SebastianHampl18/Projektarbeit-Bierautomat/Altiumprojekt/Project Outputs for Bierautomat/ESP-Träger Platine/ESP_Träger.png

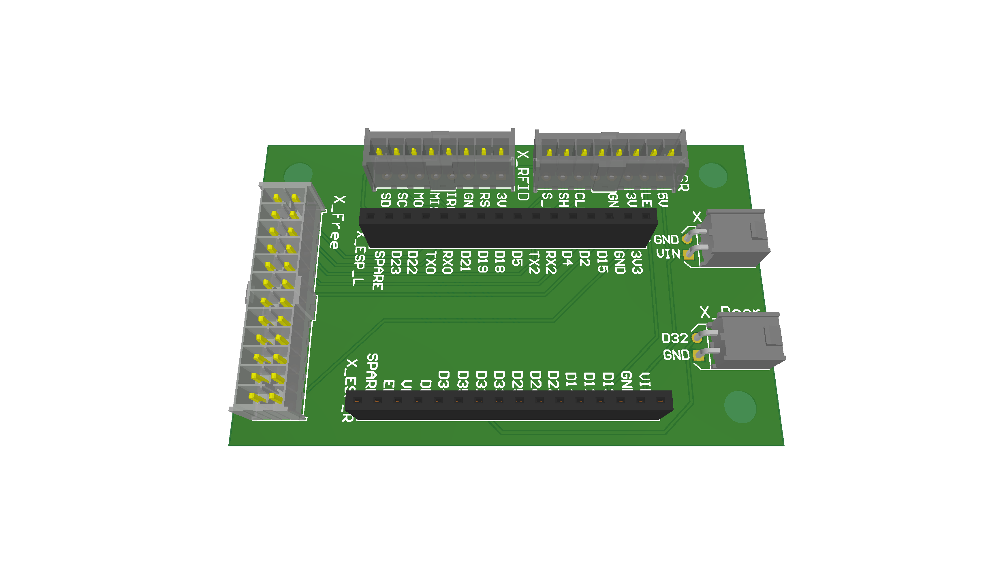
Altiumprojekt/Project Outputs for Bierautomat/ESP-Träger Platine/ESP_Träger.png
