SebastianHampl18/Projektarbeit-Bierautomat/Altiumprojekt/Project Outputs for Bierautomat/ESP-Träger Platine/ESP_Träger_top.png

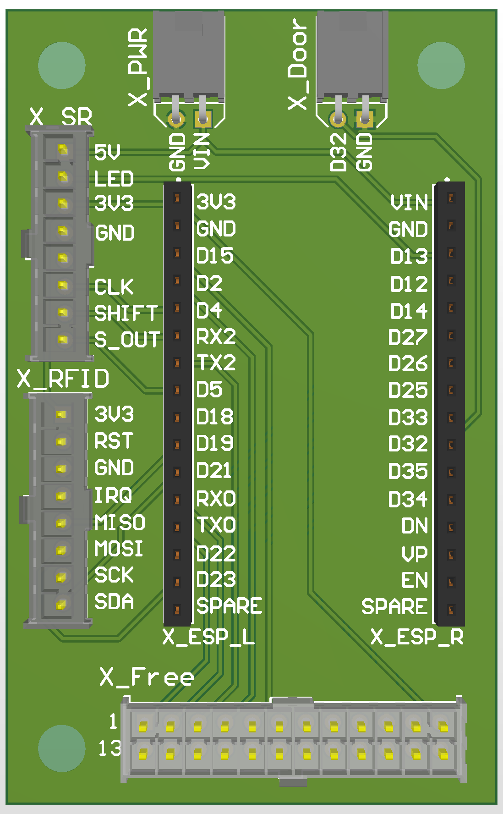
Altiumprojekt/Project Outputs for Bierautomat/ESP-Träger Platine/ESP_Träger_top.png
