SebastianHampl18/Projektarbeit-Bierautomat/Altiumprojekt/Project Outputs for Bierautomat/Schieberegister-Platine/SR_Träger_top.png

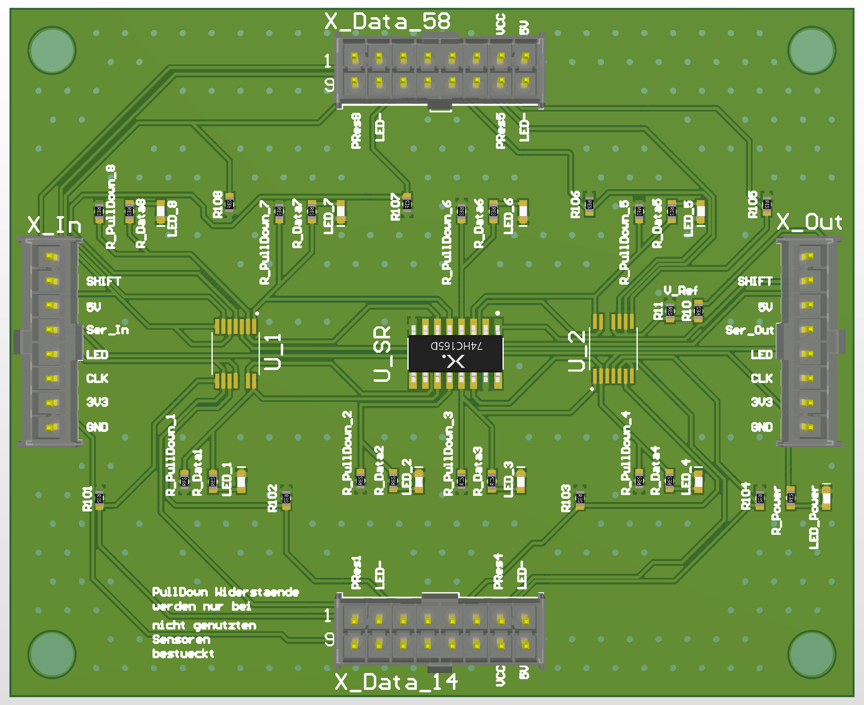
Altiumprojekt/Project Outputs for Bierautomat/Schieberegister-Platine/SR_Träger_top.png
