SebastianHampl18/Projektarbeit-Bierautomat/Altiumprojekt/Project Outputs for Bierautomat/ESP-Träger Platine/BOM_ESP_Träger.xlsx

Part Number | Manufacturer | Quantity | Value | Package | Description | Designator | Footprint | Comment
IPL1-108-01-L-S-K | Samtec | 1 |  |  | Samtec IPL1 .100", 8-polig, eine Reihe | X_RFID | Samtec-IPL1-108-01-L-S-K | Samtec-IPL1-108-01-L-S-K
IPL1-102-01-L-S-RA-K | Samtec | 2 |  |  | Samtec IPL1 .100", 2polig, eine Reihe, 90° gewinkelt | X_Door, X_PWR | Samtec-IPL1-102-01-L-S-RA-K | Samtec-IPL1-102-01-L-S-RA-K
 |  | 2 |  |  |  | X_ESP_L?, X_ESP_R? | 61301611821 | 61301611821
 |  | 1 | Samtec-IPL1-108-01-L-S-K |  | Header, 8-Pin | X_SR | Samtec-IPL1-108-01-L-S-K | Samtec-IPL1-108-01-L-S-K
 |  | 1 | Samtec-IPL1-112-01-L-D-K |  | Header, 12-Pin, Dual row | X_Free | Samtec-IPL1-112-01-L-D-K | Samtec-IPL1-112-01-L-D-K
