SebastianHampl18/Projektarbeit-Bierautomat/Altiumprojekt/Project Outputs for Bierautomat/Schieberegister-Platine/BOM_SR_Platine.xlsx

Part Number | Manufacturer | Quantity | Value | Package | Description | Designator | Footprint | Comment
R___=Value |  | 17 |  |  | Resistor, 0603, 5% default, 0.1 W | R101, R102, R103, R104, R105, R106, R107, R108, R_PullDown_1, R_PullDown_2, R_PullDown_3, R_PullDown_4, R_PullDown_5, R_PullDown_6, R_PullDown_7, R_PullDown_8, R_PullDown_SER | 0603_resistor_flat | R___=Value, 2k7
R___220 |  | 8 | 220 |  | Resistor, 0603, 5% default, 0.1 W | R1, R2, R3, R4, R5, R6, R7, R8 | 0603_resistor_flat | R___220
R_0603_1%_xx |  | 2 | xx |  | Resistor, 0603, 5% default, 0.1 W | R10, R11 | 0603_resistor_flat | R_0603_1%_xx
R_0603_1%_3k3 |  | 9 | 3k3 |  | Resistor, 0603, 5% default, 0.1 W | R_Data1, R_Data2, R_Data3, R_Data4, R_Data5, R_Data6, R_Data7, R_Data8, R_Power | 0603_resistor_flat | R_0603_1%_3k3
150060*75000 | Würth | 9 |  |  | 0603 SMD mono-color Chip LED, WL-SMCW BS: Blue, GS: Green, RS: Red, SS: super red, VS: bright green, YS: yellow | LED_1, LED_2, LED_3, LED_4, LED_5, LED_6, LED_7, LED_8, LED_Power | 150060XX75000 | 150060*75000
 |  | 1 |  |  | MOSFET N-CH 30V 3.8A SOT23 | Q_LED | SOT95P280X125-3N | AO3418
 |  | 2 |  | TSSOP-14 Rohm | Quad differential comparator, automotive grade 14-TSSOP -40 to 125 | U_1, U_2 | SOP65P640X120-14N | LM2901PWR
 |  | 2 | Samtec |  | Header, 8-Pin, Dual row | X_Data_14, X_Data_58 | Samtec-IPL1-108-01-L-D-K | Samtec-IPL1-108-01-L-D-K
 |  | 2 | Samtec-IPL1-108-01-L-S-K |  | Header, 8-Pin | X_In, X_Out | Samtec-IPL1-108-01-L-S-K | Samtec-IPL1-108-01-L-S-K
 | Nexperia | 1 |  | SOT109-1 | IC SHIFT REGST 8BIT PI-SO 16SOIC | U_SR | FP-SOT109-1-MFG | 74HC165D,653
