SebastianHampl18/Projektarbeit-Bierautomat/Altiumprojekt/Project Outputs for Bierautomat/Schieberegister-Platine/Electrical Rules Check_SR_Platine.PDF

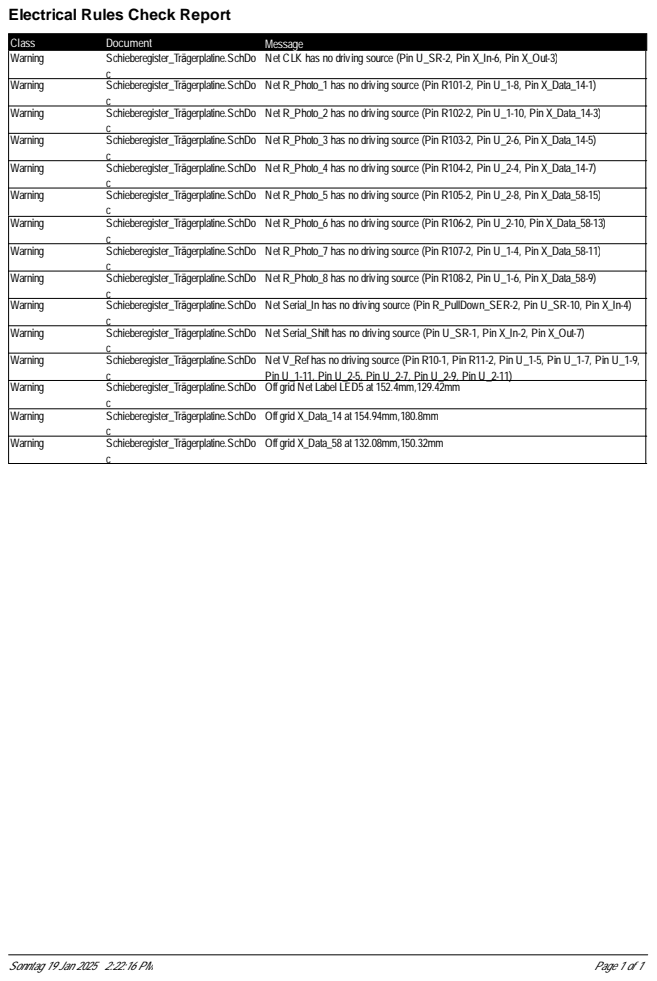
[picture p25: page 1]

Electrical Rules Check Report

Net CLK has no driving source (Pin U_SR-2, Pin X_In-6, Pin X_Out-3)

Net R_Photo_1 has no driving source (Pin R101-2, Pin U_1-8, Pin X_Data_14-1)

Net R_Photo_2 has no driving source (Pin R102-2, Pin U_1-10, Pin X_Data_14-3)

Net R_Photo_3 has no driving source (Pin R103-2, Pin U_2-6, Pin X_Data_14-5)

Net R_Photo_4 has no driving source (Pin R104-2, Pin U_2-4, Pin X_Data_14-7)

Net R_Photo_5 has no driving source (Pin R105-2, Pin U_2-8, Pin X_Data_58-15)

Net R_Photo_6 has no driving source (Pin R106-2, Pin U_2-10, Pin X_Data_58-13)

Net R_Photo_7 has no driving source (Pin R107-2, Pin U_1-4, Pin X_Data_58-11)

Net R_Photo_8 has no driving source (Pin R108-2, Pin U_1-6, Pin X_Data_58-9)

Net Serial_In has no driving source (Pin R_PullDown_SER-2, Pin U_SR-10, Pin X_In-4)

Net Serial_Shift has no driving source (Pin U_SR-1, Pin X_In-2, Pin X_Out-7)

Net V_Ref has no driving source (Pin R10-1, Pin R11-2, Pin U_1-5, Pin U_1-7, Pin U_1-9,
Pin U_1-11, Pin U_2-5, Pin U_2-7, Pin U_2-9, Pin U_2-11)
Off grid Net Label LED5 at 152.4mm,129.42mm
