SebastianHampl18/Projektarbeit-Bierautomat/Altiumprojekt/Project Outputs for Bierautomat/ESP-Träger Platine/Assembly_ESP_Träger.PDF

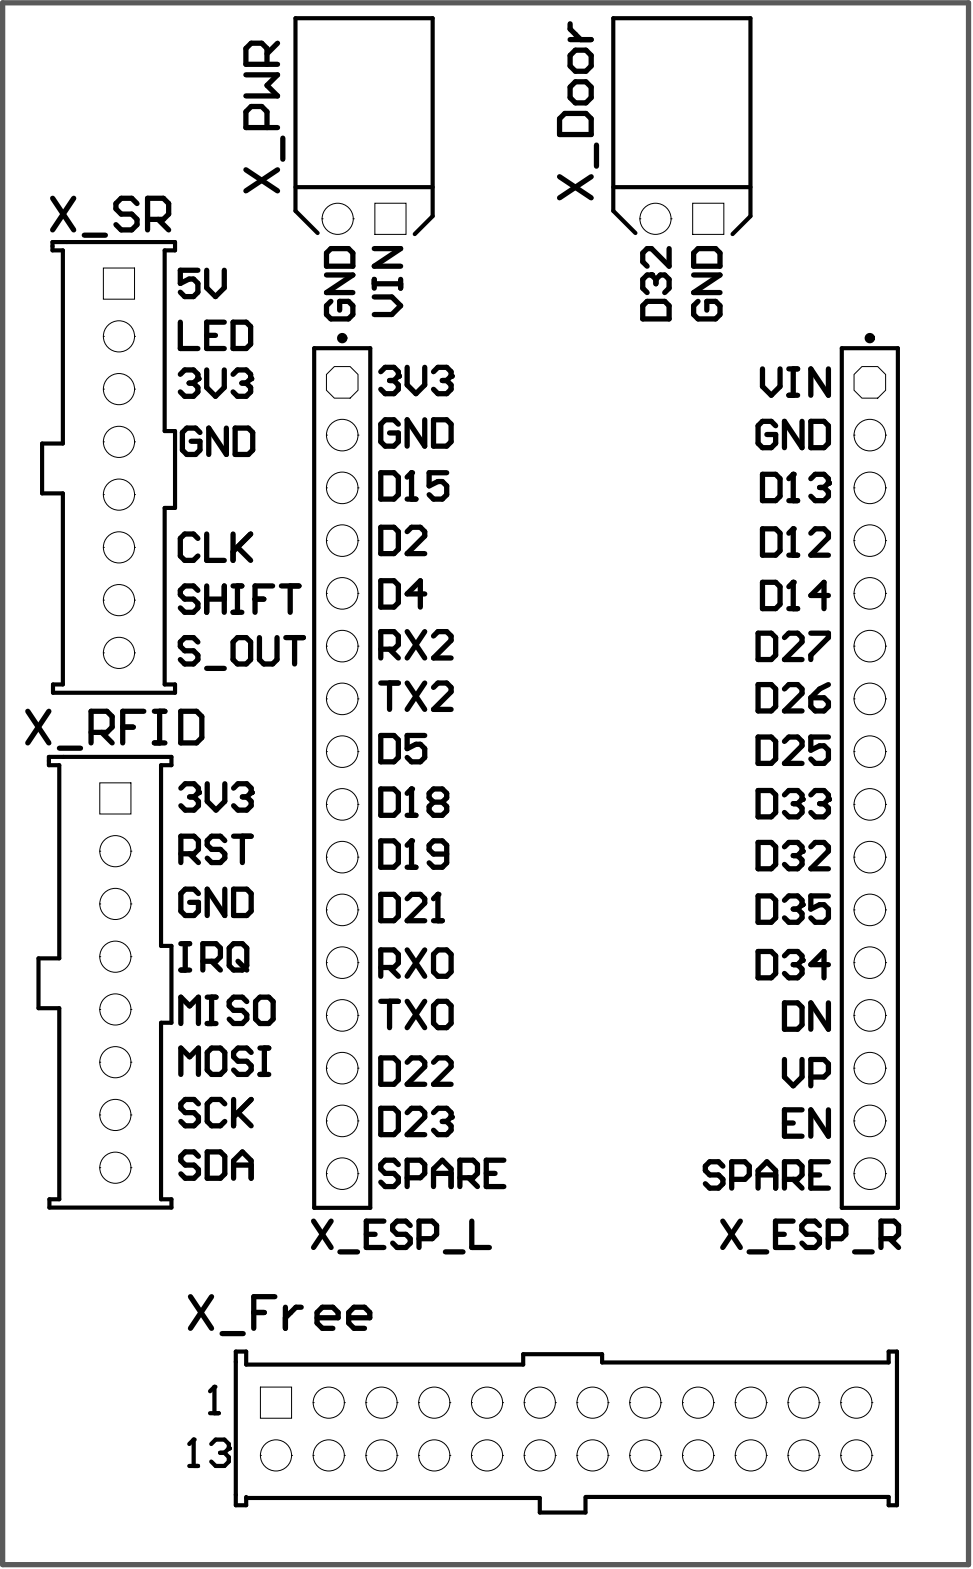
[picture p26: page 1]

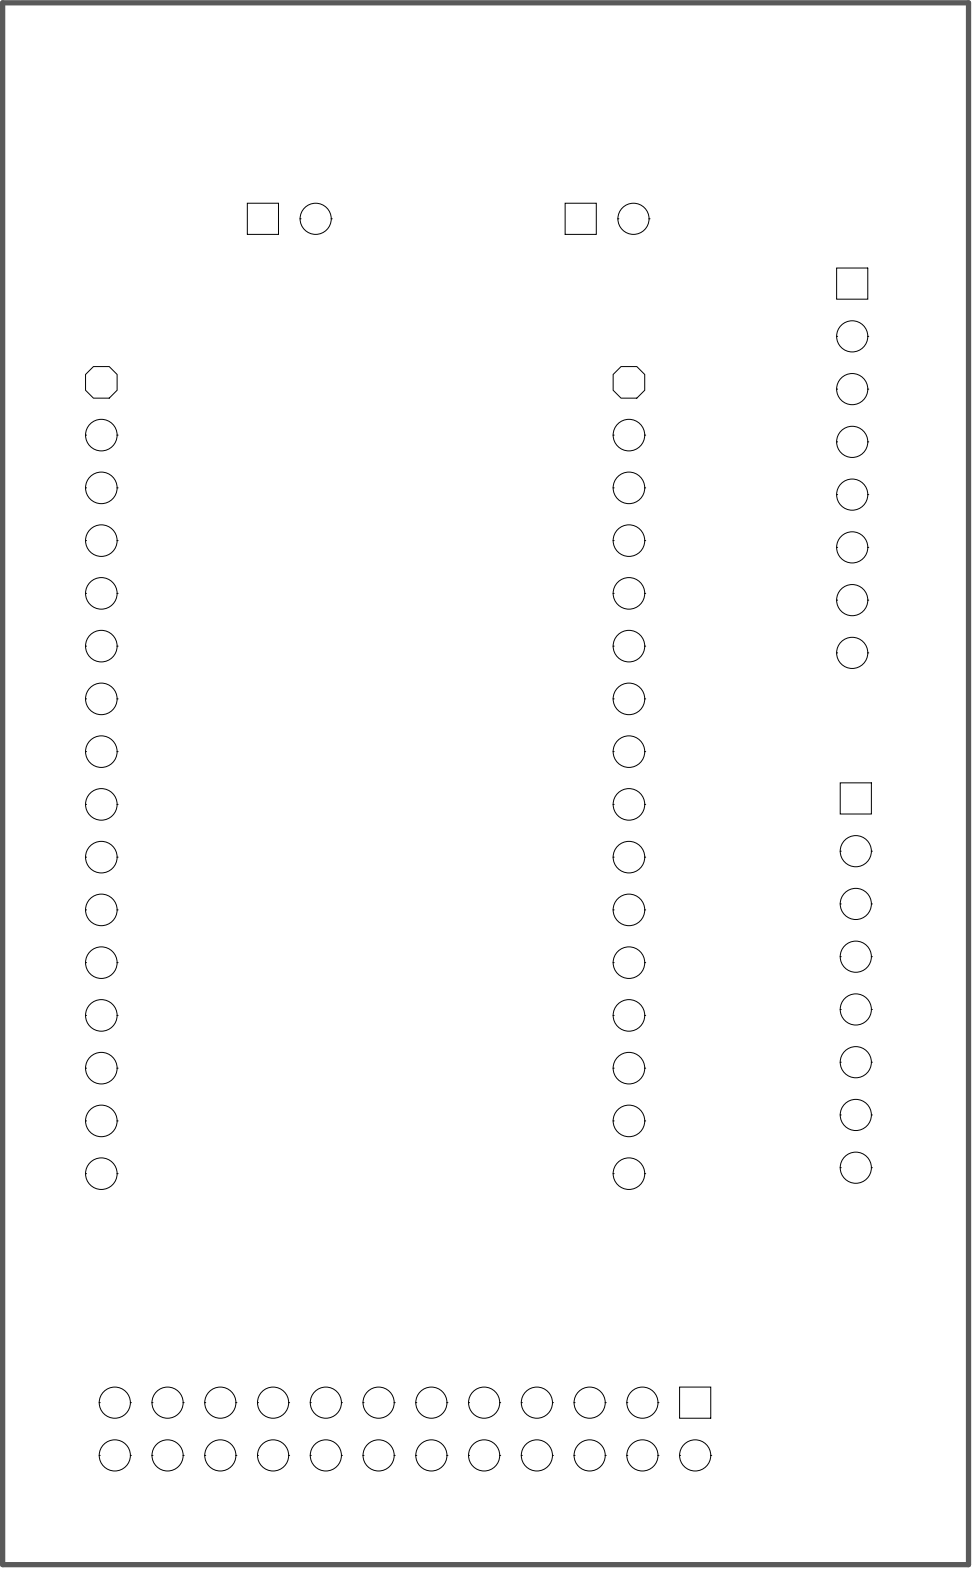
[picture p27: page 2]
