SebastianHampl18/Projektarbeit-Bierautomat/Altiumprojekt/Project Outputs for Bierautomat/ESP-Träger Platine/Schematics_ESP_Träger.PDF

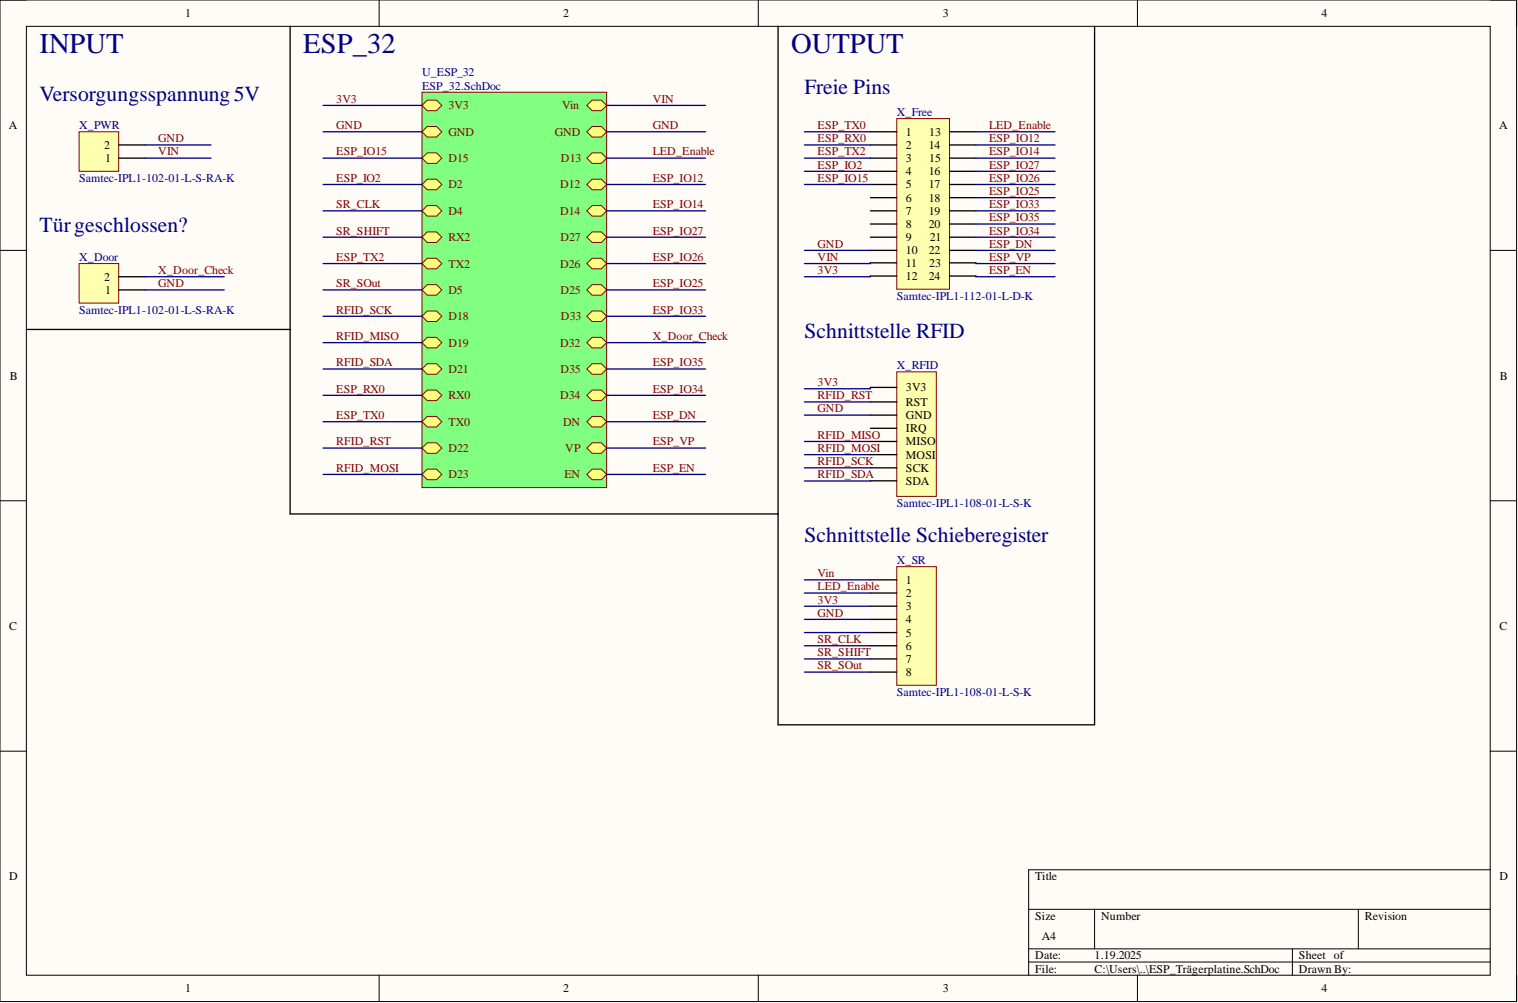
[picture p28: page 1]

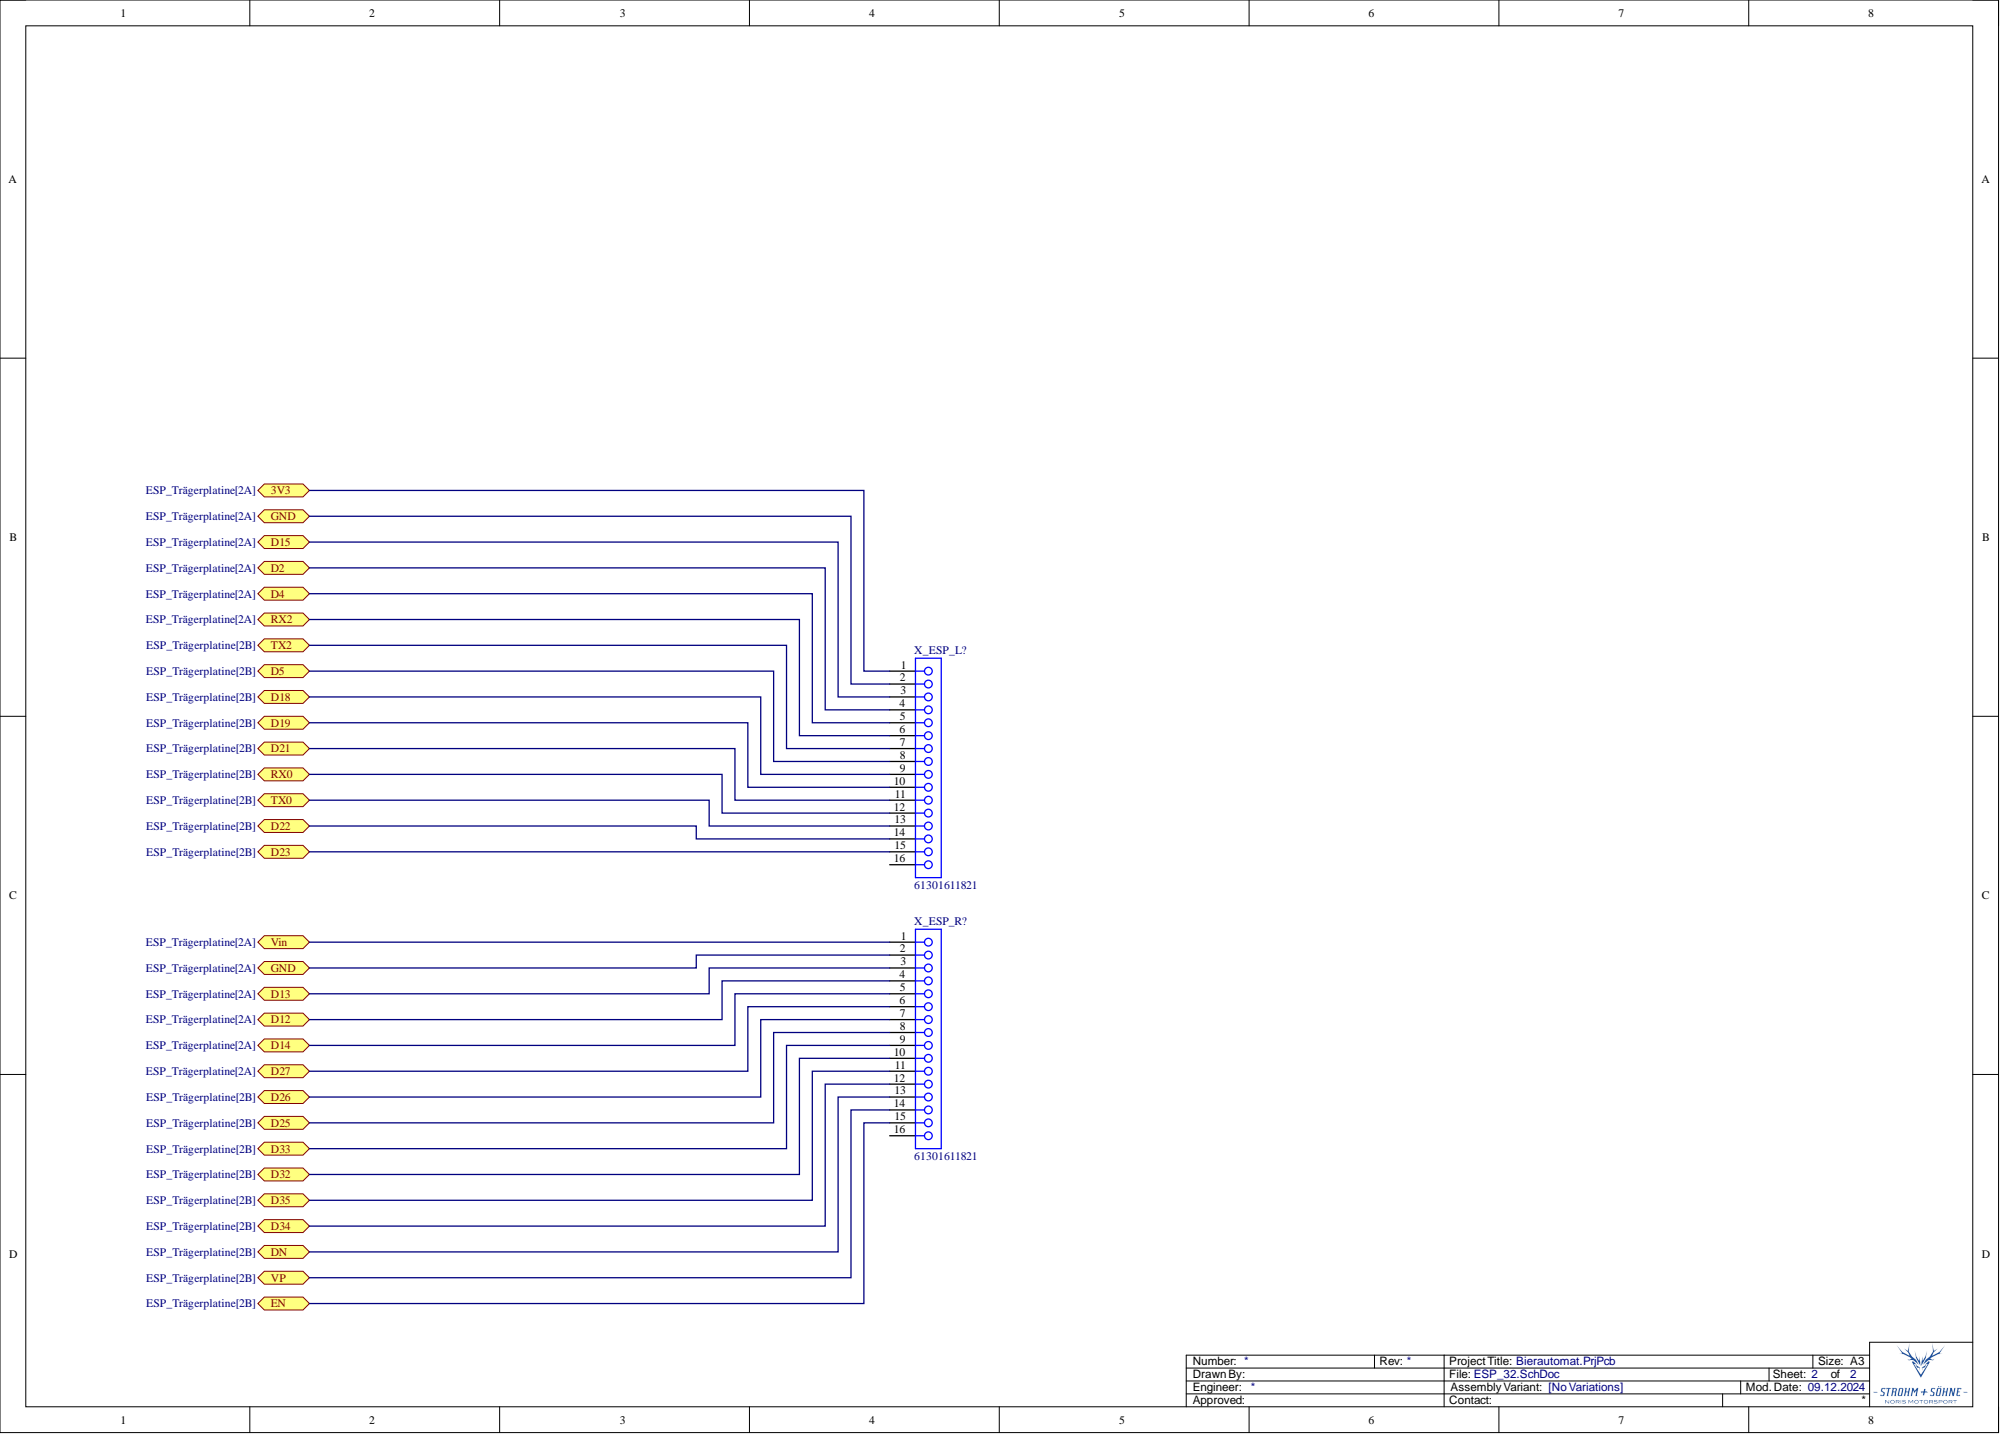
[picture p29: page 2]

Numbe r : * | R e v : * | Projec t Title: Bierautomat .Prj P c b | Siz e : A3
Drawn By : | File : ESP_32.Sc h D o c | Sheet : 2 o f 2
Engineer : * | As sembly Variant : [ No Variations ] | Mod. Date: 09.12.20 2 4
