SebastianHampl18/Projektarbeit-Bierautomat/Altiumprojekt/Project Outputs for Bierautomat/Schieberegister-Platine/Assembly_SR_Platine.PDF

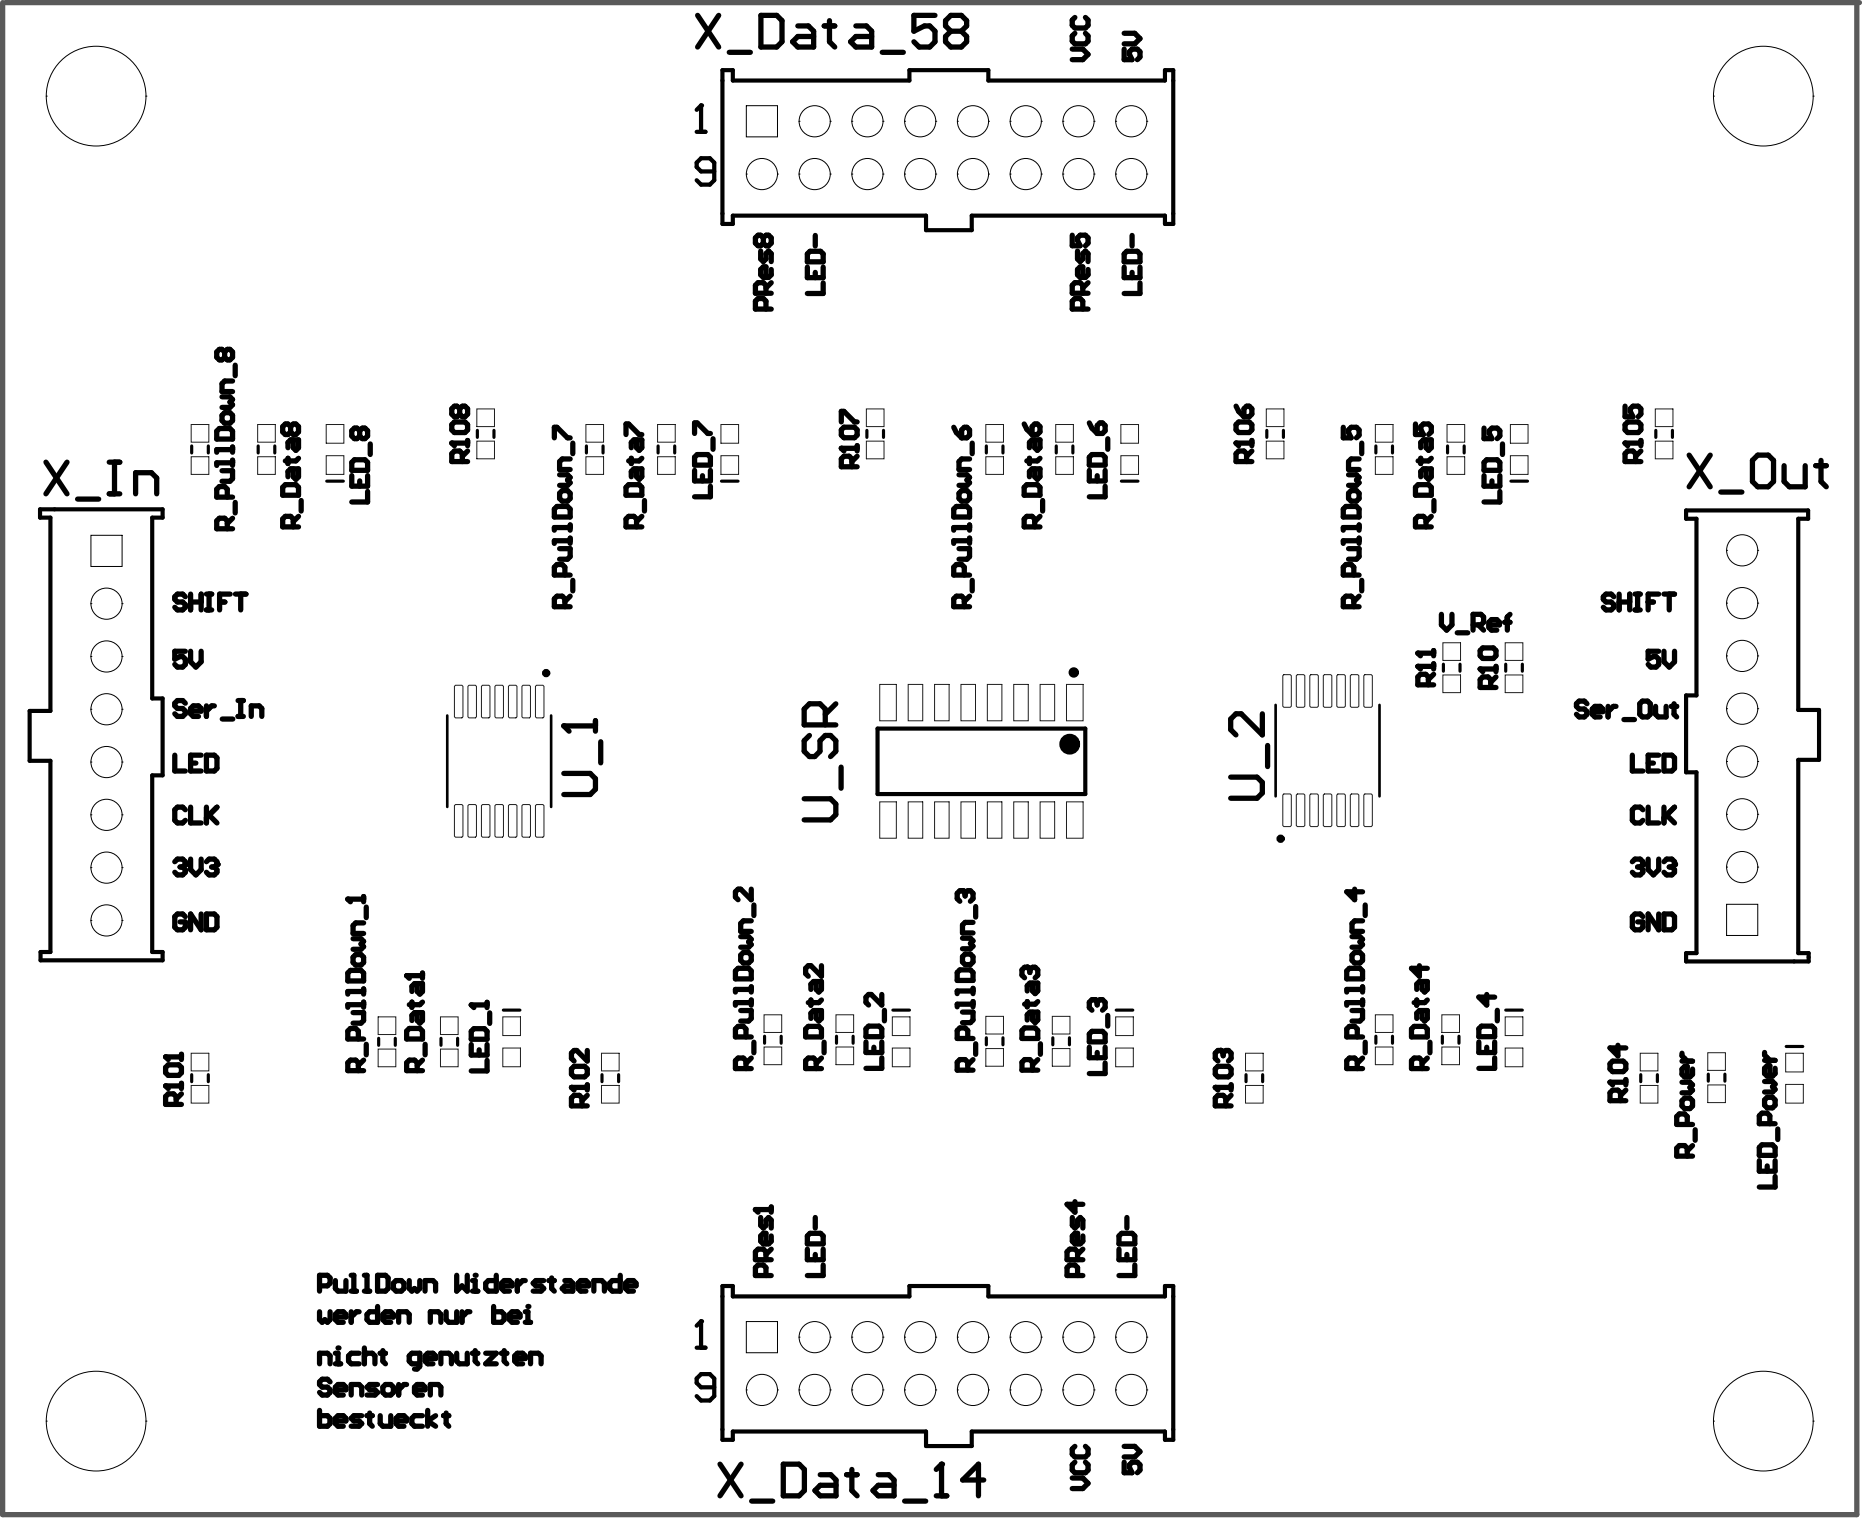
[picture p30: page 1]

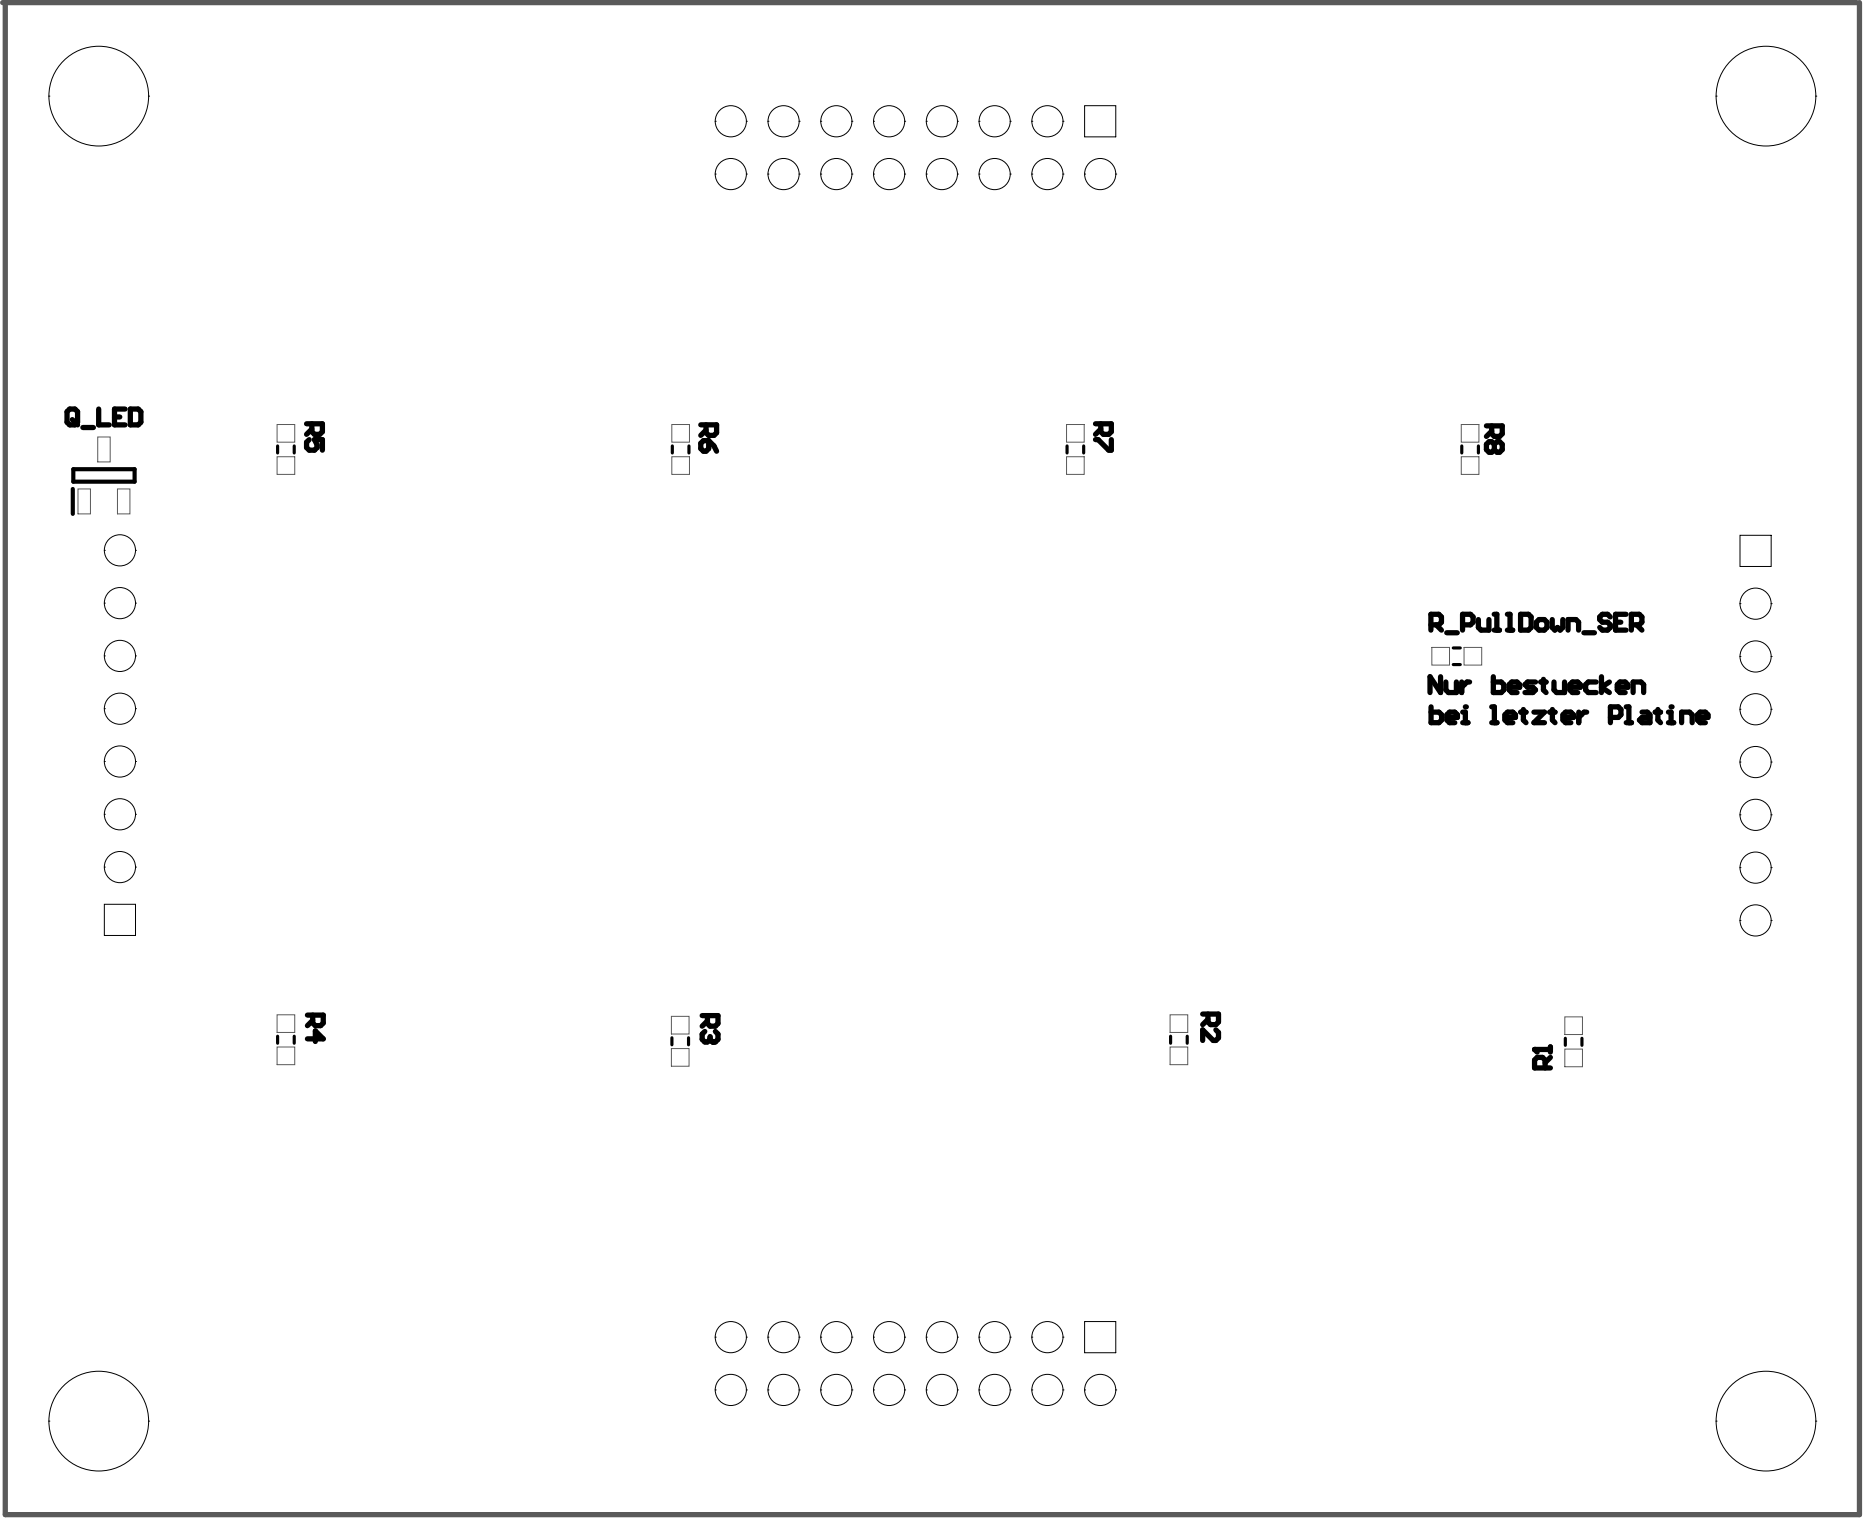
[picture p31: page 2]
