SebastianHampl18/Projektarbeit-Bierautomat/Altiumprojekt/Project Outputs for Bierautomat/Schieberegister-Platine/Schematics_SR_Platine.PDF

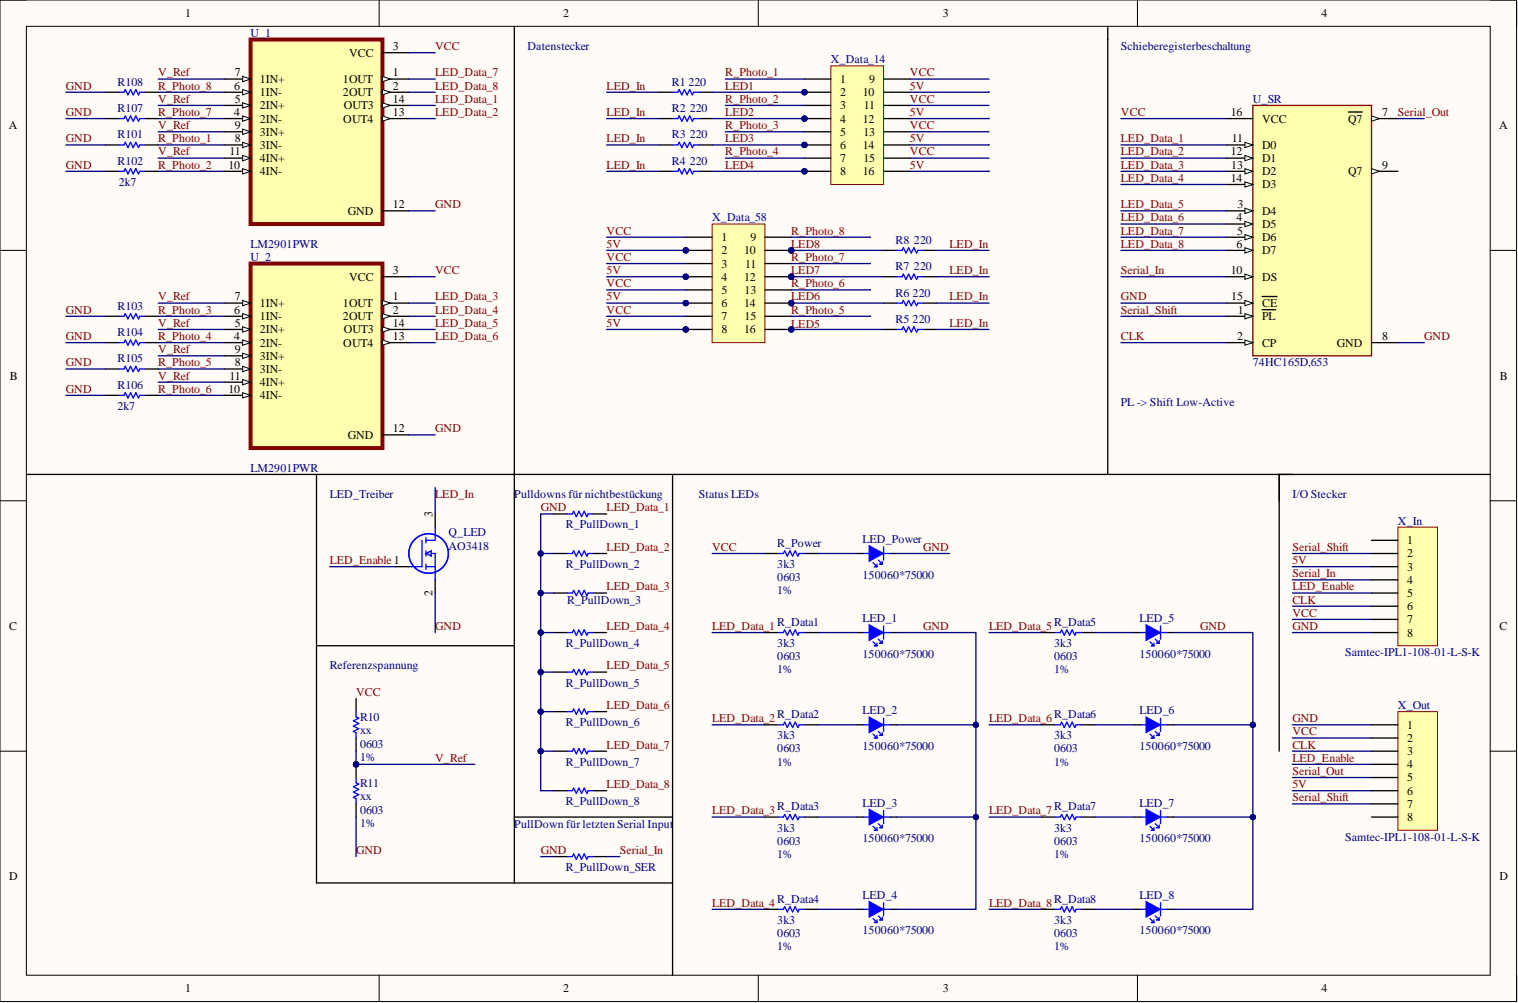
[picture p32: page 1]

PL -> Shift Low-Active

PullDown für letzten Serial Input
