SebastianHampl18/Projektarbeit-Bierautomat/Altiumprojekt/Project Outputs for Bierautomat/ESP-Träger Platine/PCB Print/PCB_Bottom_ESP_Träger.PDF

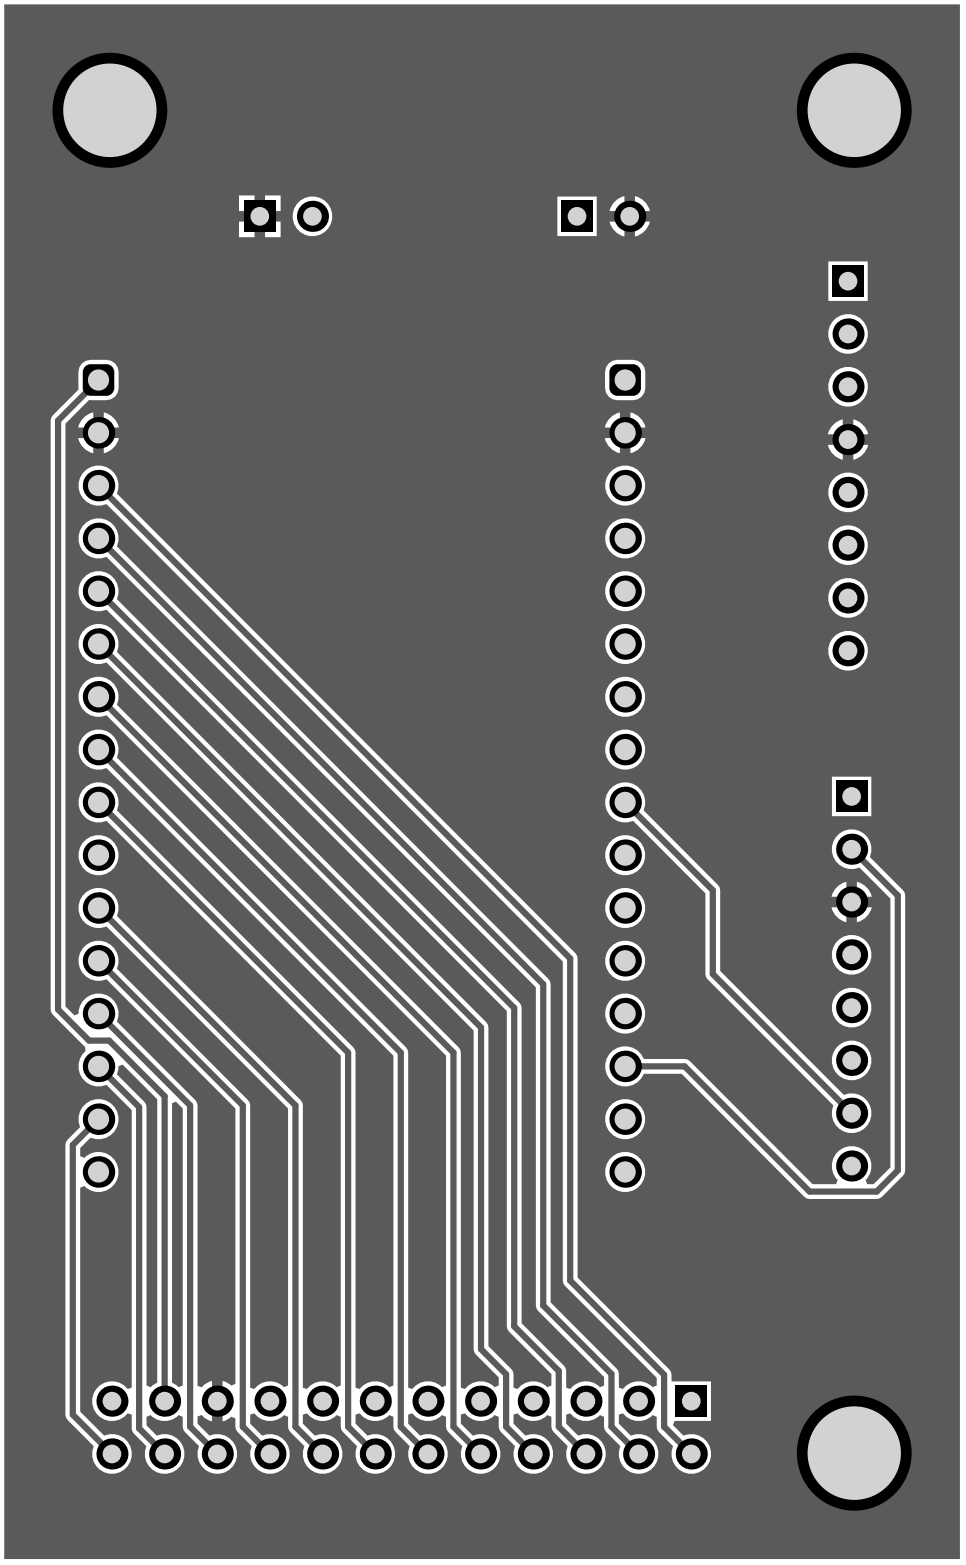
[picture p33: page 1]
