SebastianHampl18/Projektarbeit-Bierautomat/Altiumprojekt/Project Outputs for Bierautomat/ESP-Träger Platine/PCB Print/PCB_Top_ESP_Träger.PDF

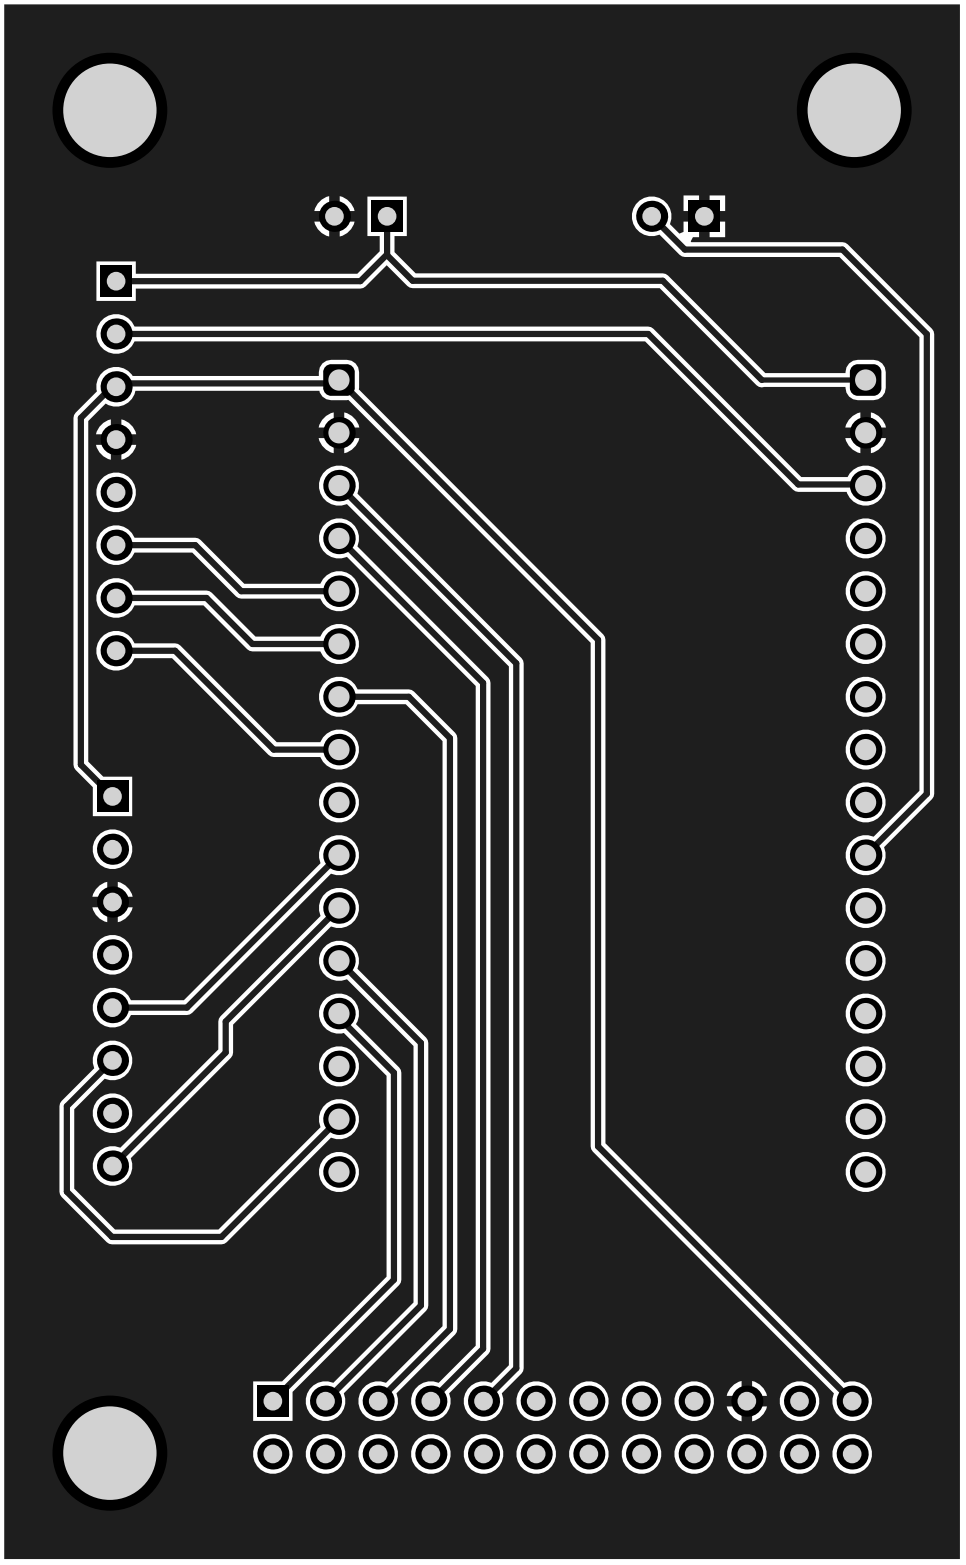
[picture p34: page 1]
