SebastianHampl18/Projektarbeit-Bierautomat/Altiumprojekt/Project Outputs for Bierautomat/Schieberegister-Platine/PCB Print/PCB_Bottom_SR_Platine.PDF

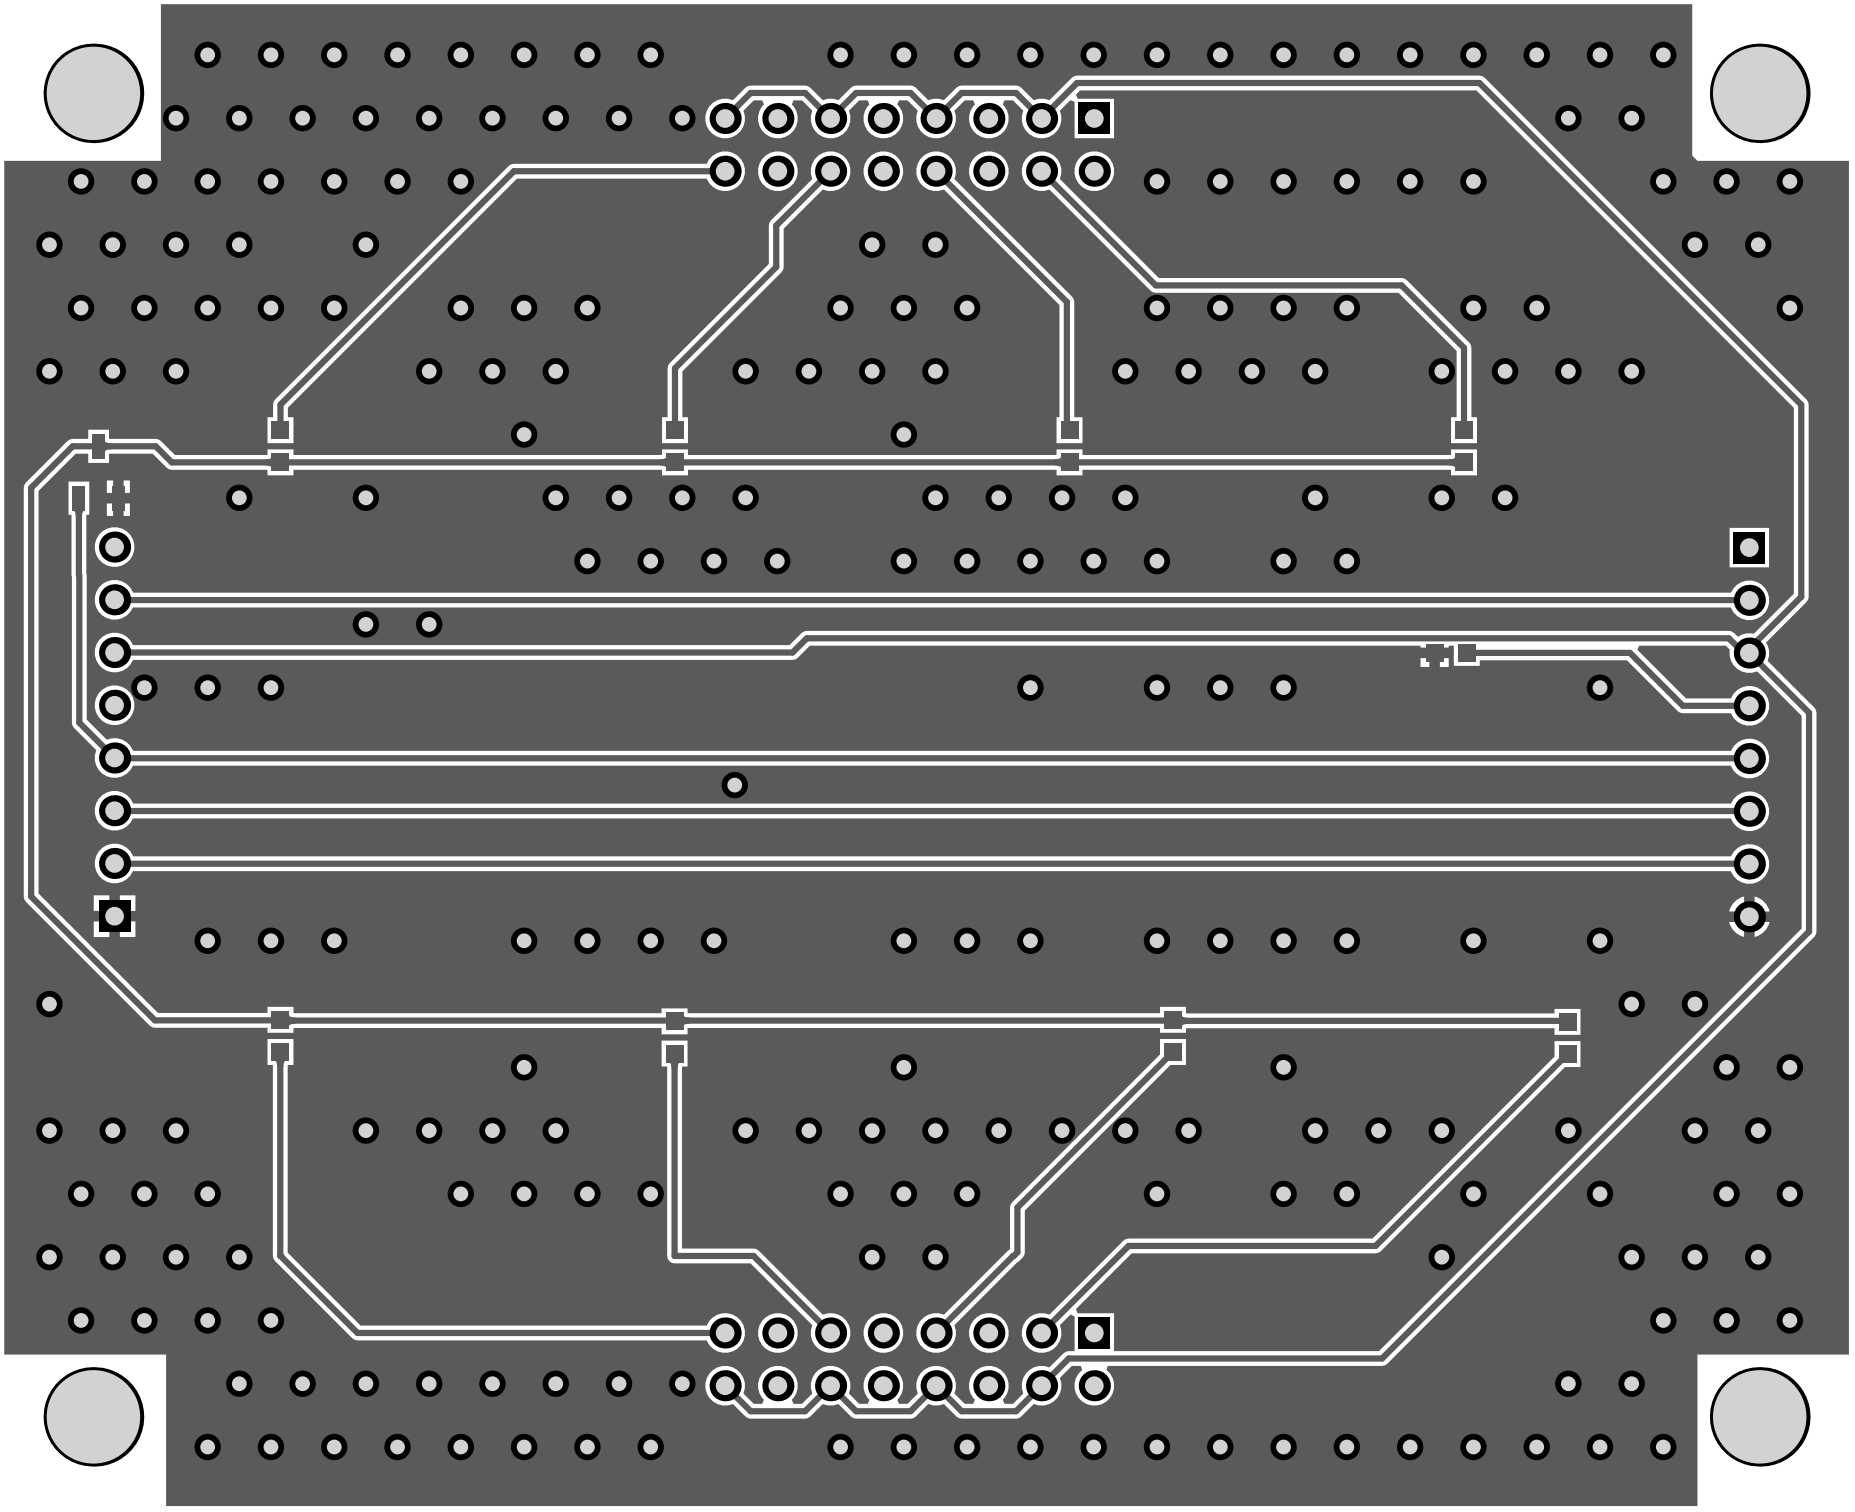
[picture p35: page 1]
