SebastianHampl18/Projektarbeit-Bierautomat/Altiumprojekt/Project Outputs for Bierautomat/Schieberegister-Platine/PCB Print/PCB_Top_SR_Platine.PDF

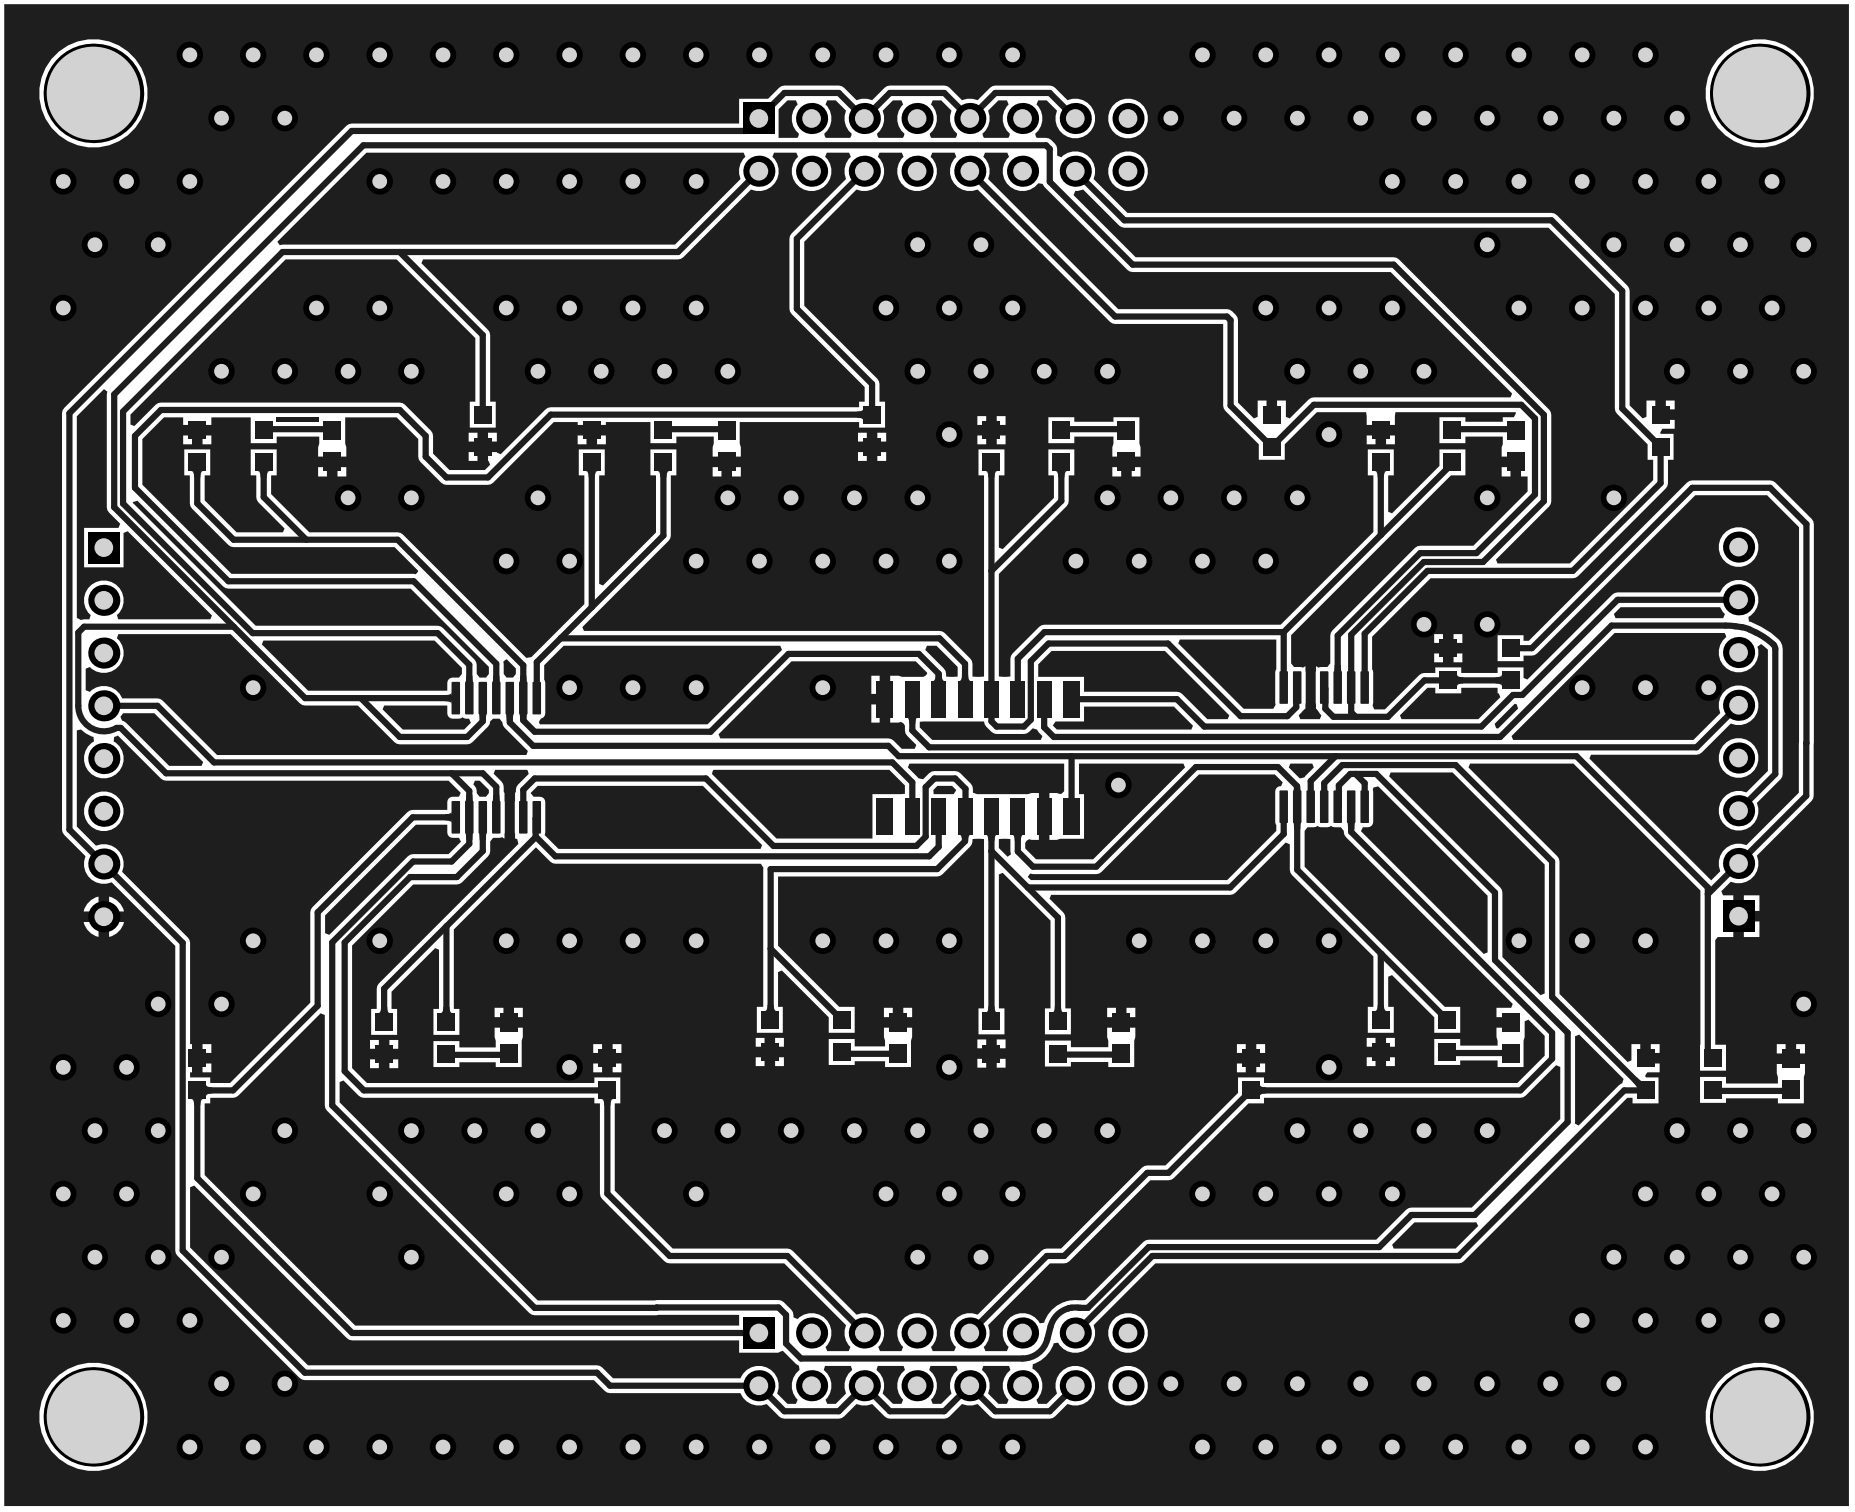
[picture p36: page 1]
