SebastianHampl18/Projektarbeit-Bierautomat/Altiumprojekt/Project Outputs for Bierautomat/ESP-Träger Platine/3D_View_Bird_ESP_Träger.PDF

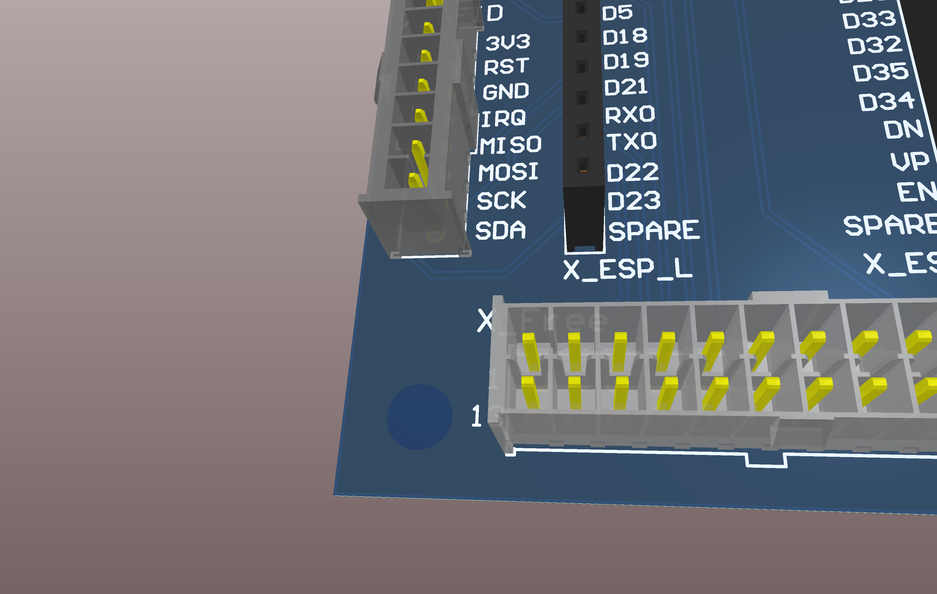
[picture p37: page 1]
