SebastianHampl18/Projektarbeit-Bierautomat/Altiumprojekt/Project Outputs for Bierautomat/ESP-Träger Platine/3D_View_Bot_ESP_Träger.PDF

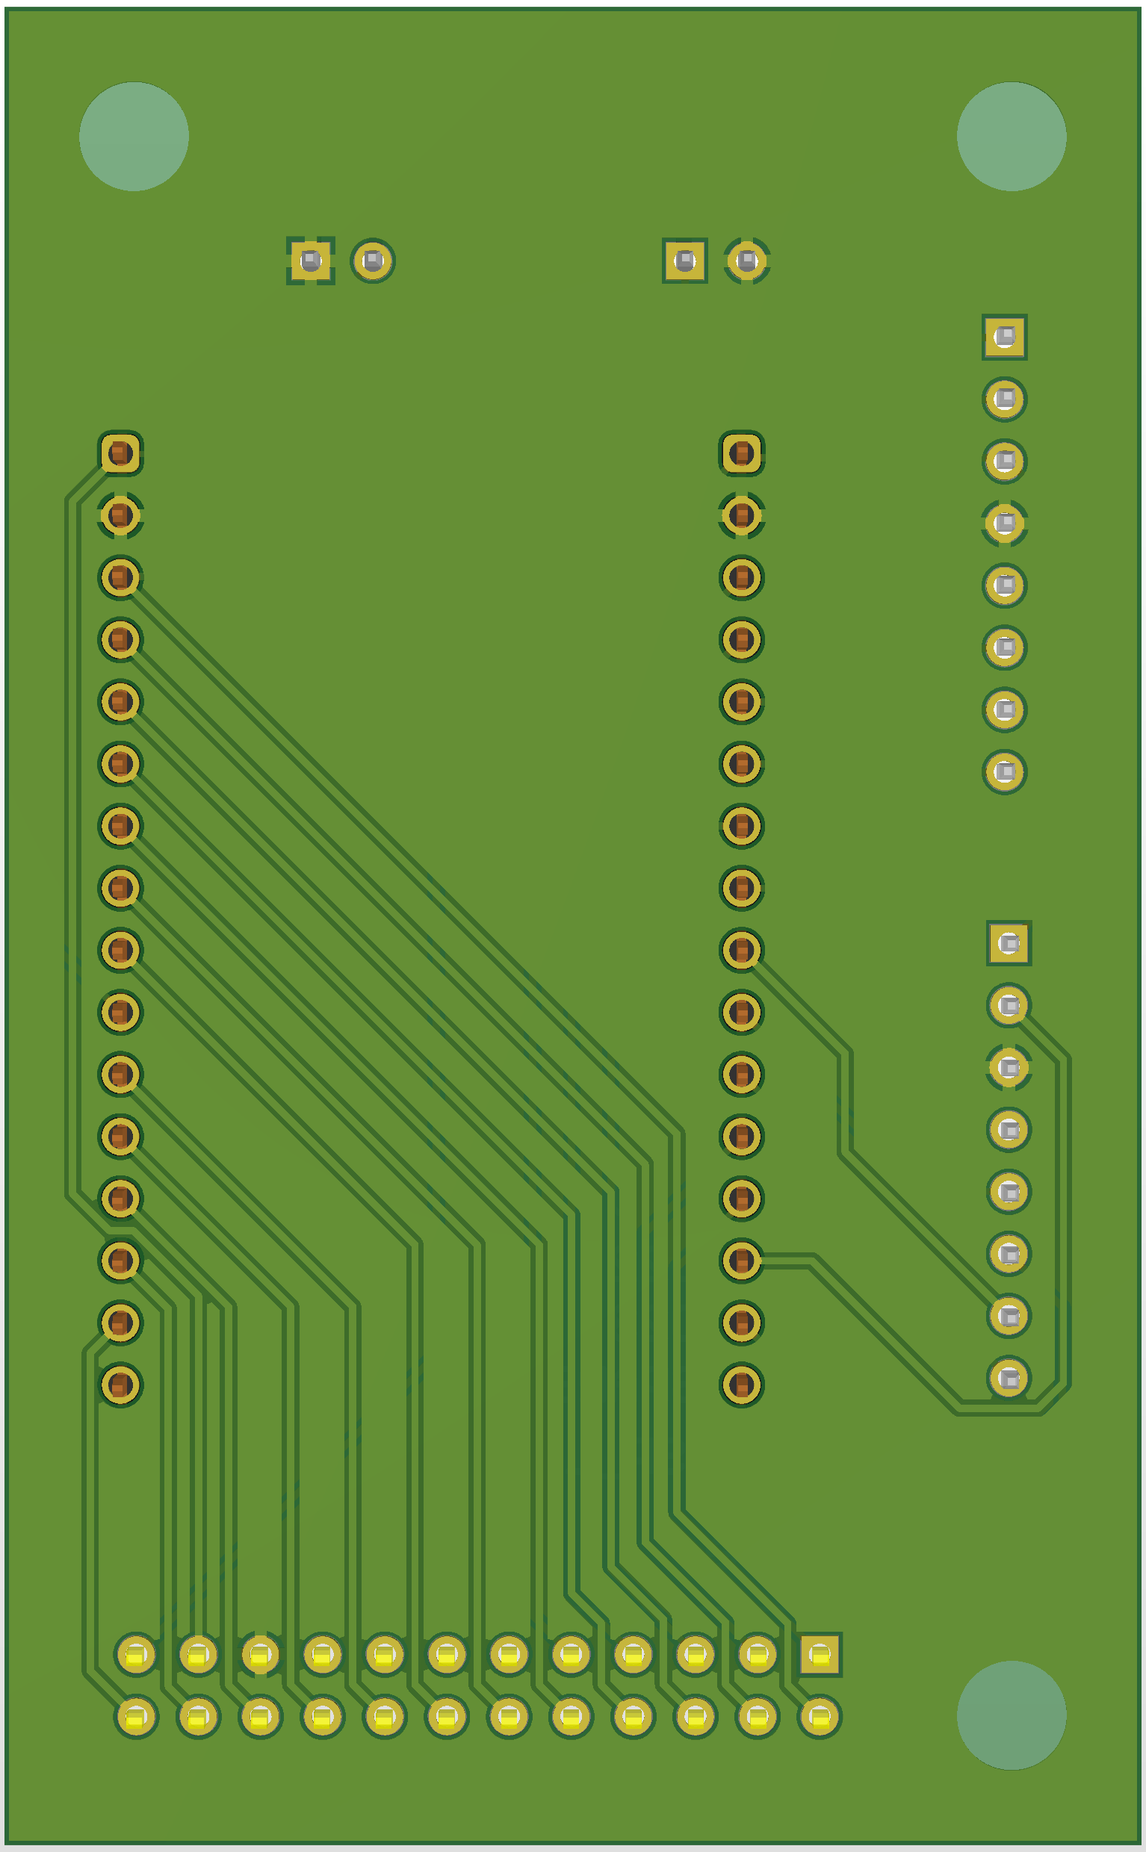
[picture p38: page 1]
