SebastianHampl18/Projektarbeit-Bierautomat/Altiumprojekt/Project Outputs for Bierautomat/ESP-Träger Platine/3D_View_Top_ESP_Träger.PDF

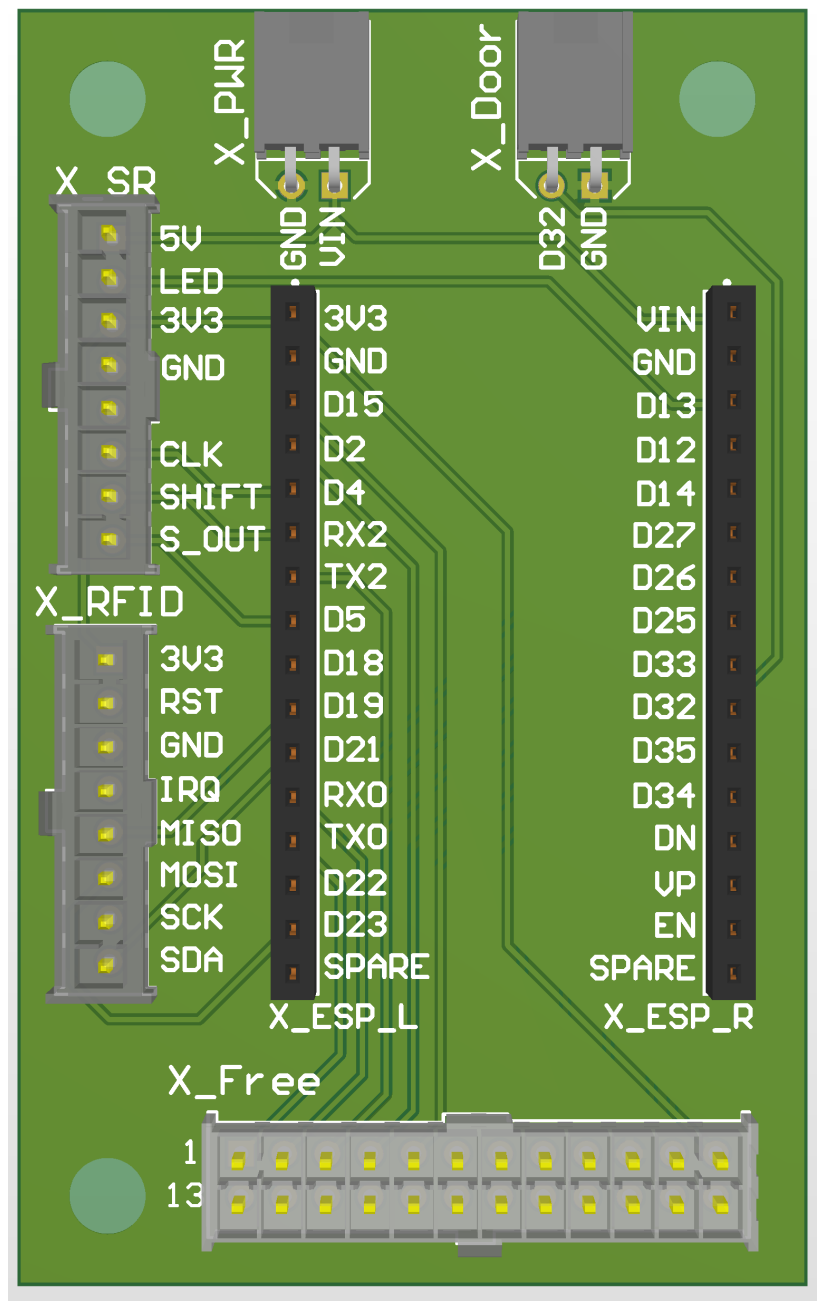
[picture p39: page 1]
