SebastianHampl18/Projektarbeit-Bierautomat/Altiumprojekt/Project Outputs for Bierautomat/ESP-Träger Platine/PCB_Dimensions_ESP_Träger.PDF

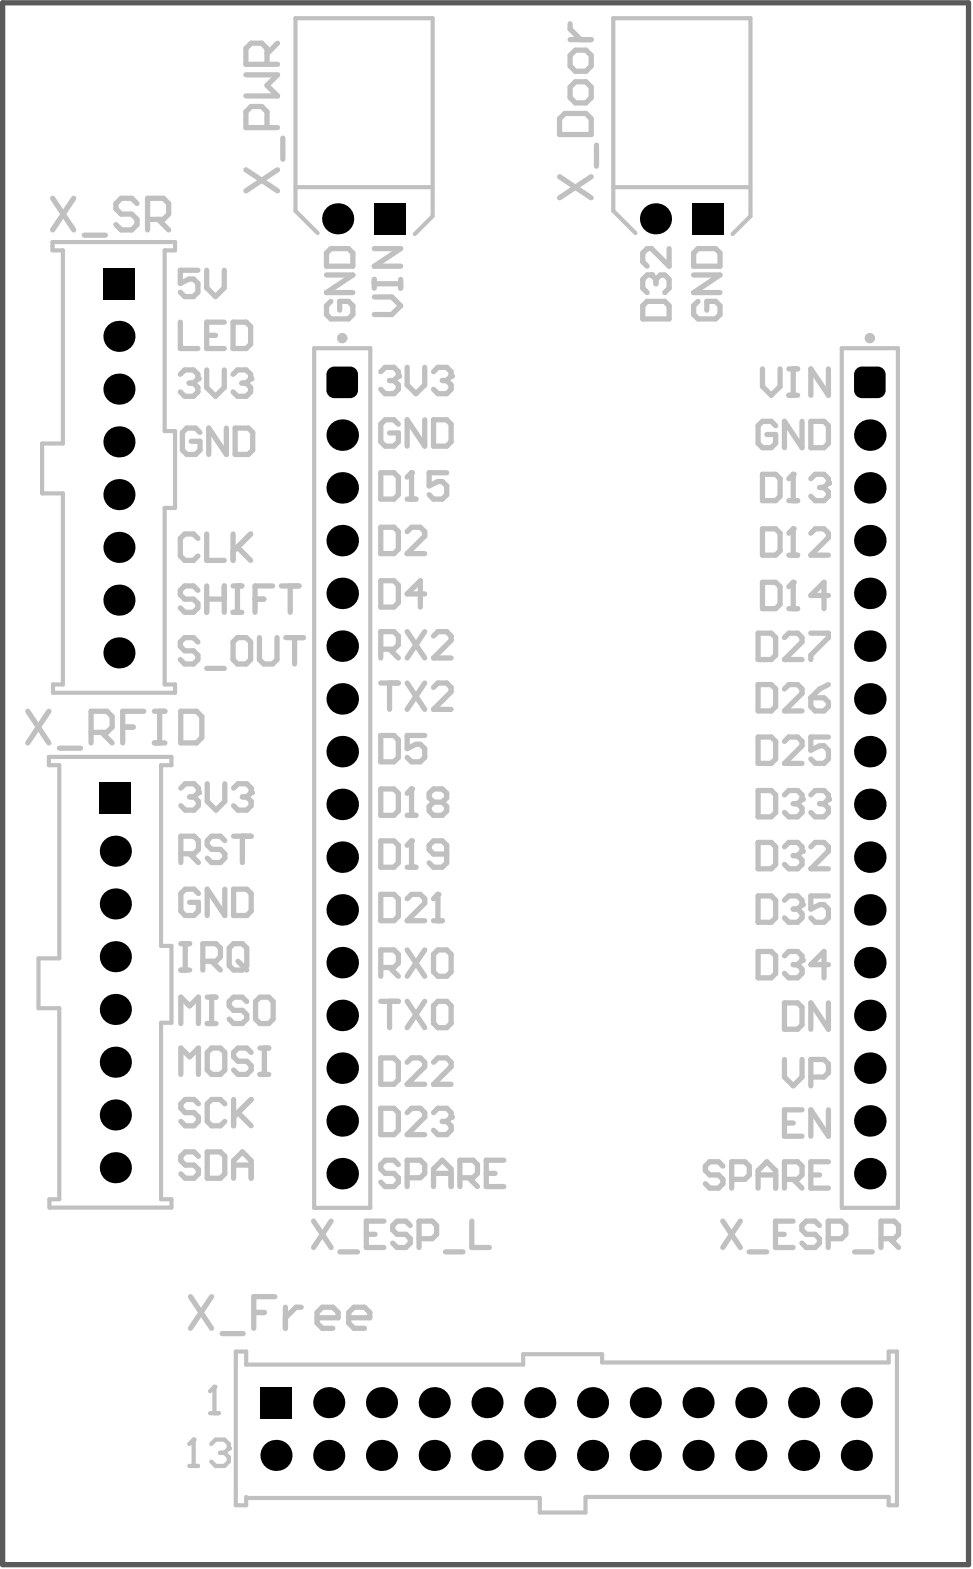
[picture p40: page 1]

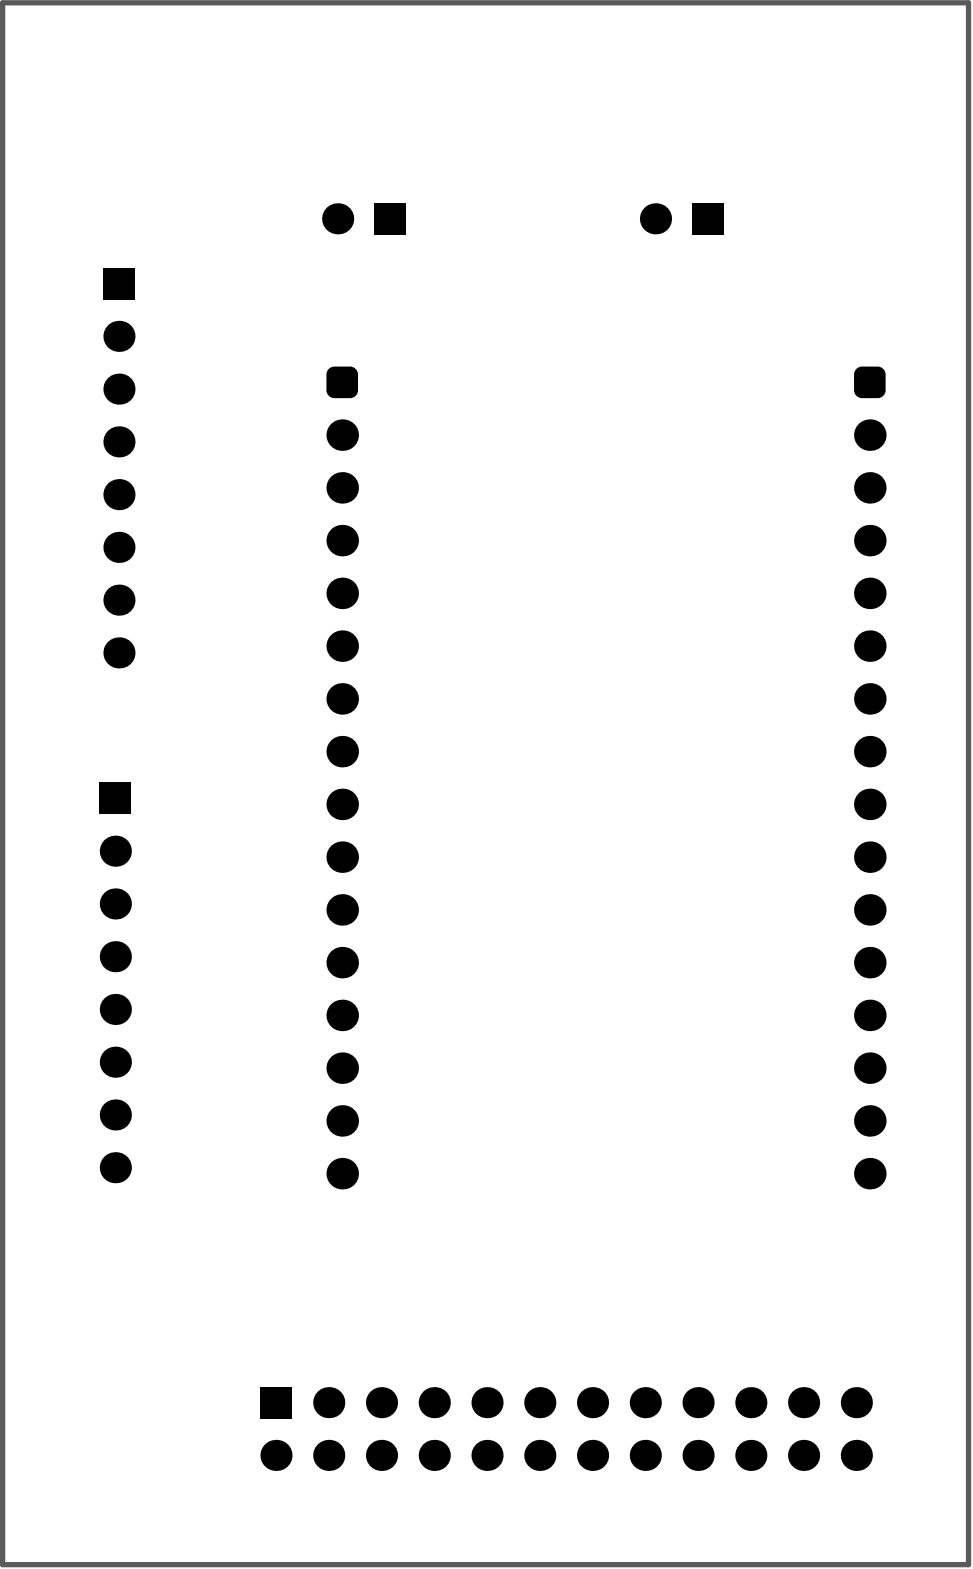
[picture p41: page 2]
