SebastianHampl18/Projektarbeit-Bierautomat/Altiumprojekt/Project Outputs for Bierautomat/Schieberegister-Platine/3D_View_Bird_SR_Platine.PDF

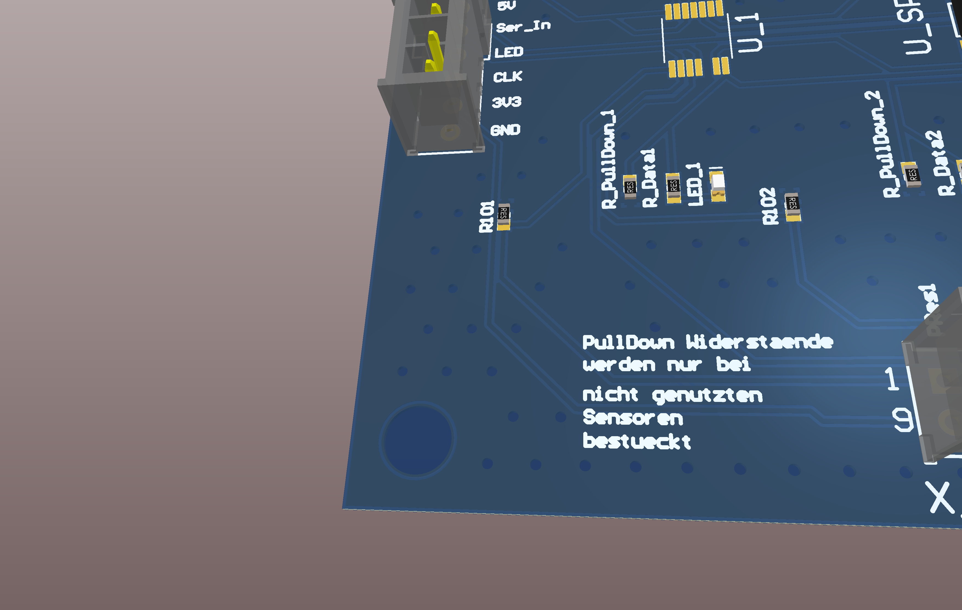
[picture p42: page 1]
