SebastianHampl18/Projektarbeit-Bierautomat/Altiumprojekt/Project Outputs for Bierautomat/Schieberegister-Platine/3D_View_Bot_SR_Platine.PDF

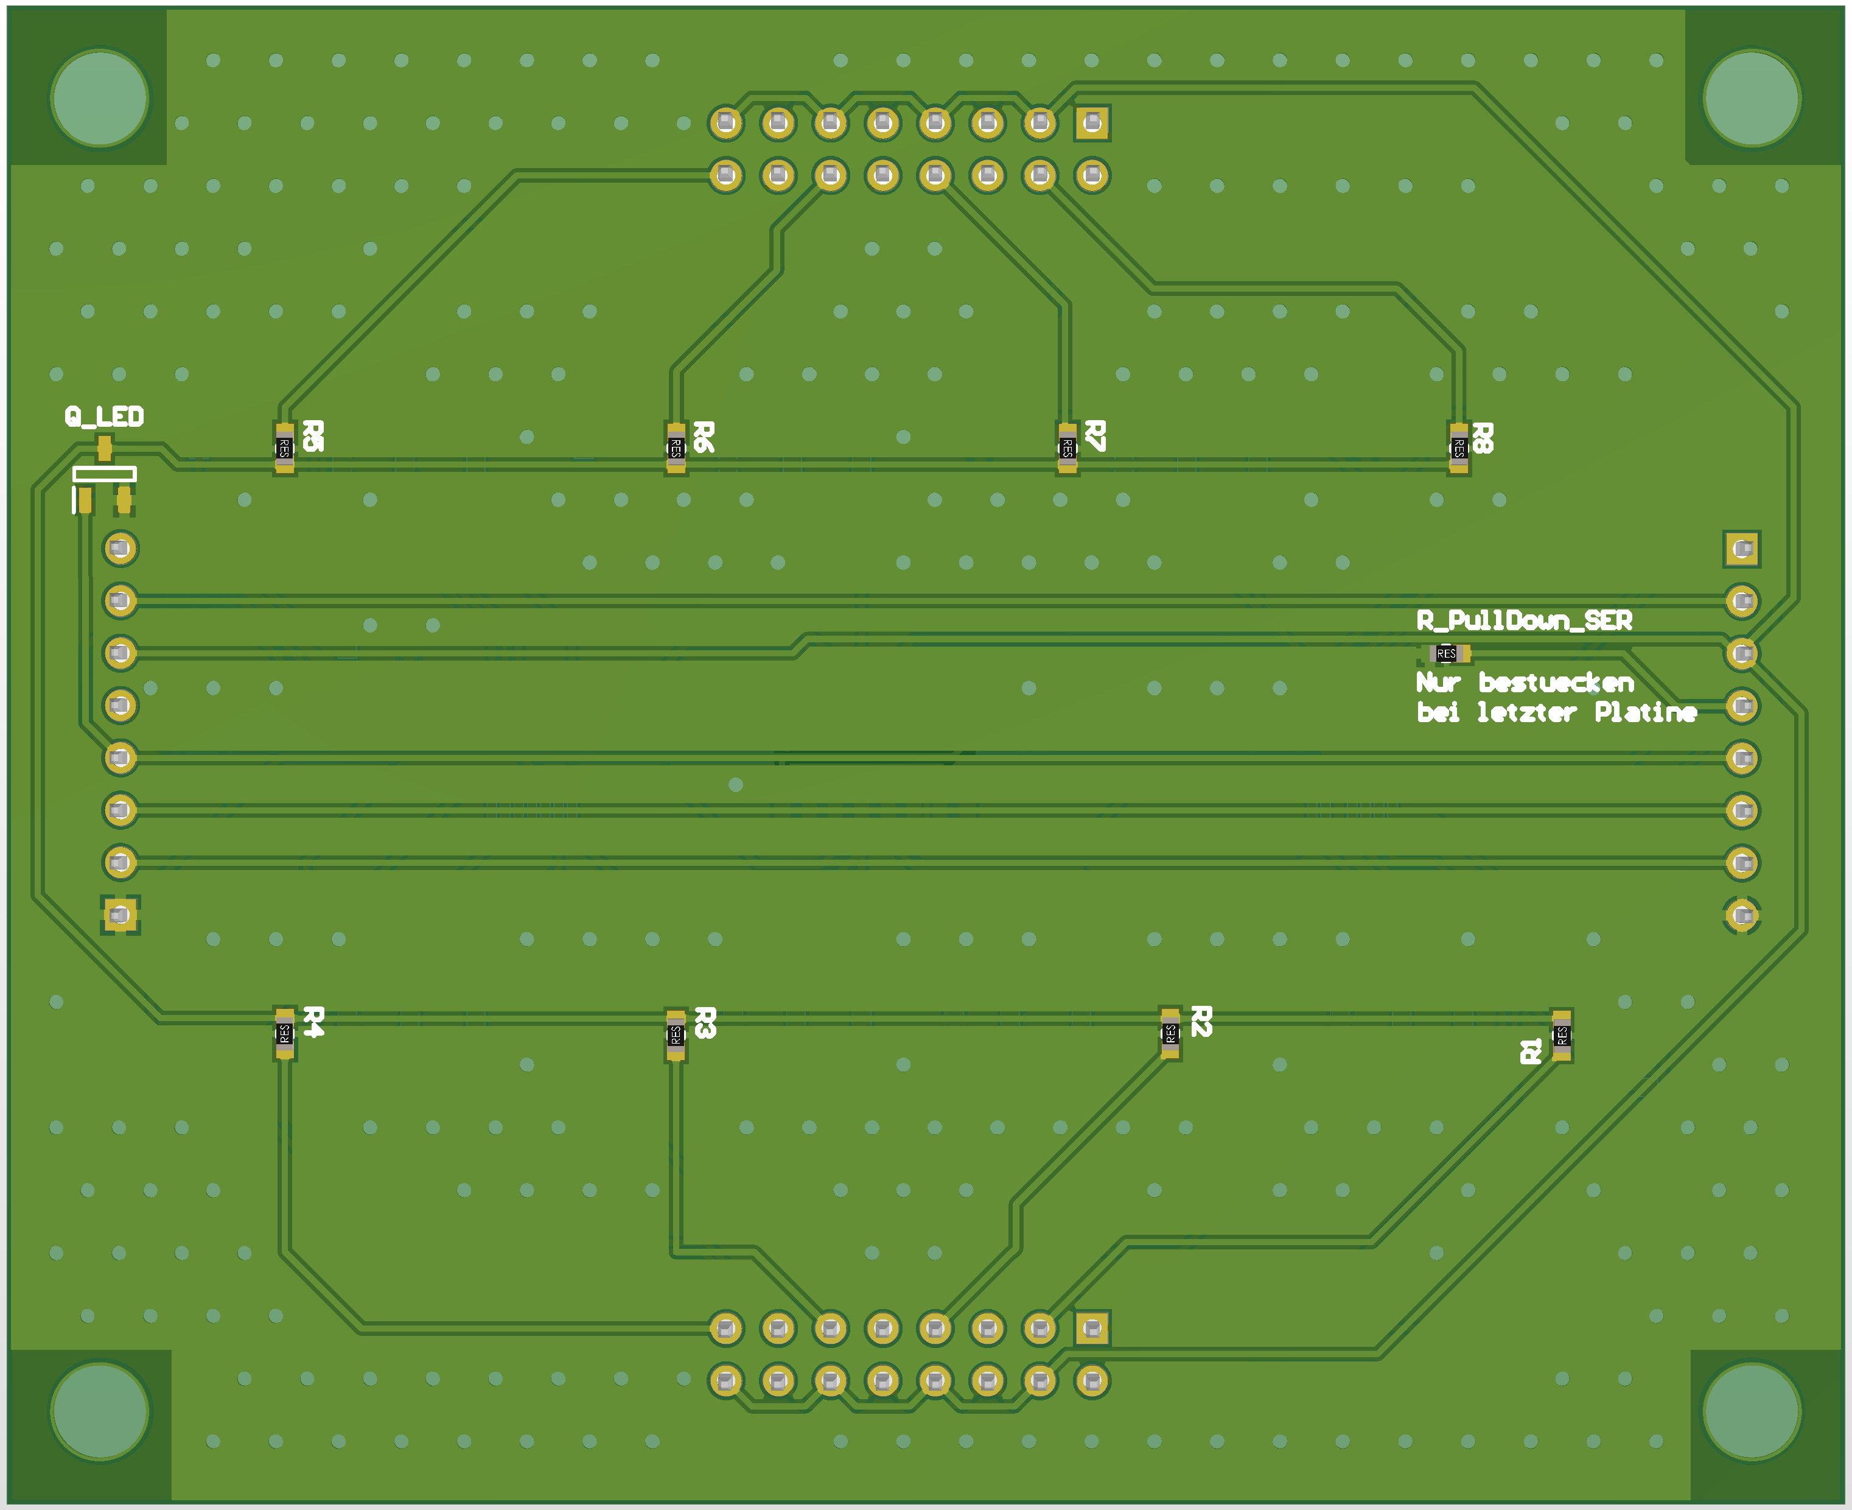
[picture p43: page 1]
