SebastianHampl18/Projektarbeit-Bierautomat/Altiumprojekt/Project Outputs for Bierautomat/Schieberegister-Platine/3D_View_Top_SR_Platine.PDF

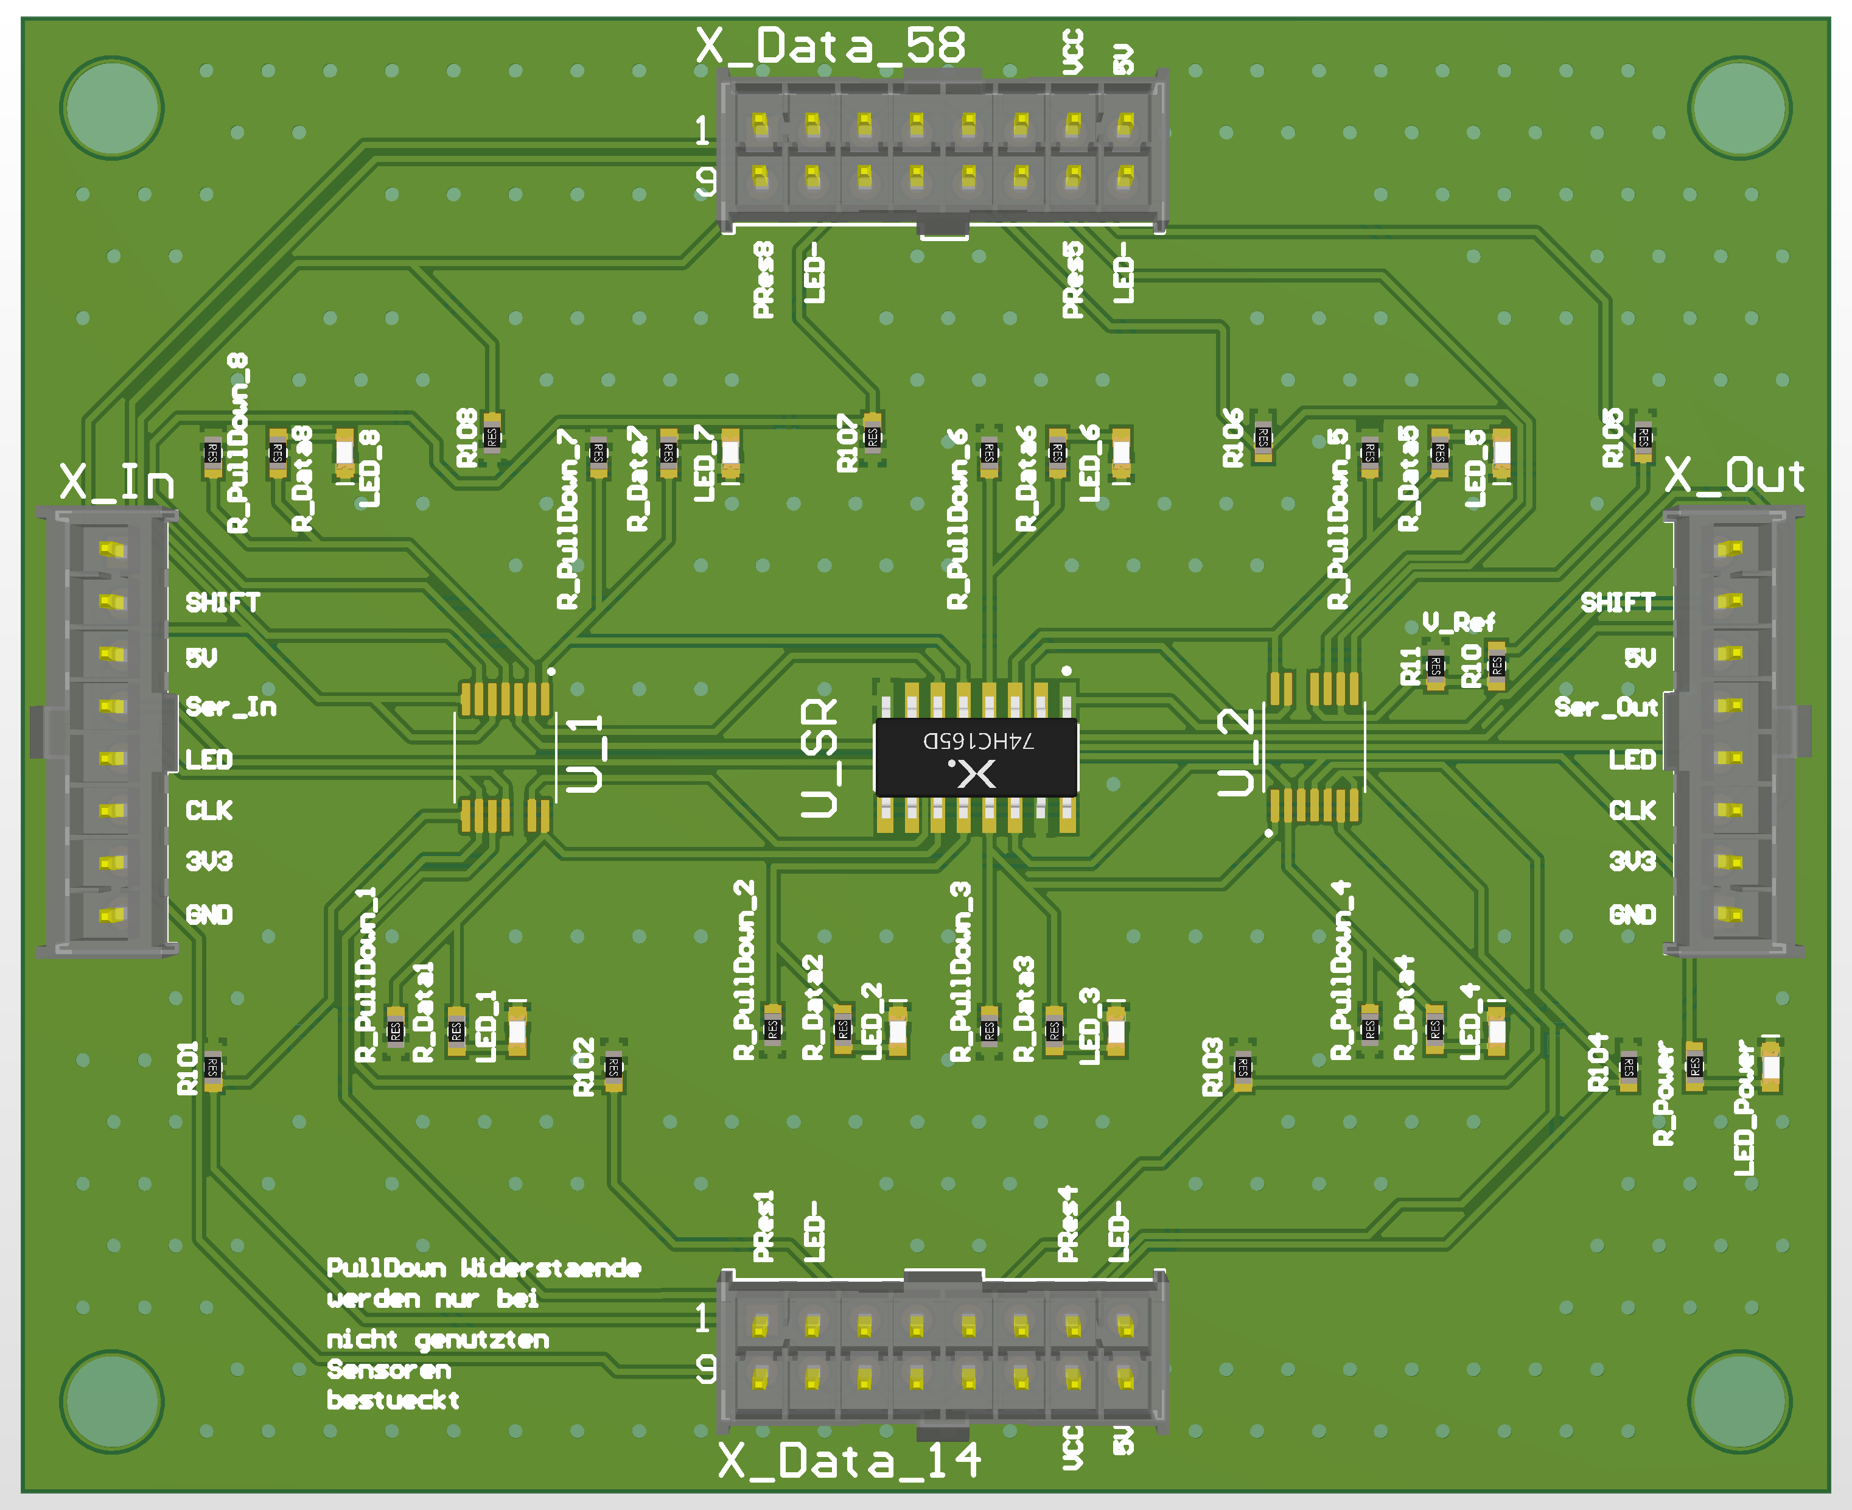
[picture p44: page 1]
