SebastianHampl18/Projektarbeit-Bierautomat/Altiumprojekt/Project Outputs for Bierautomat/Schieberegister-Platine/PCB_Dimensions_SR_Platine.PDF

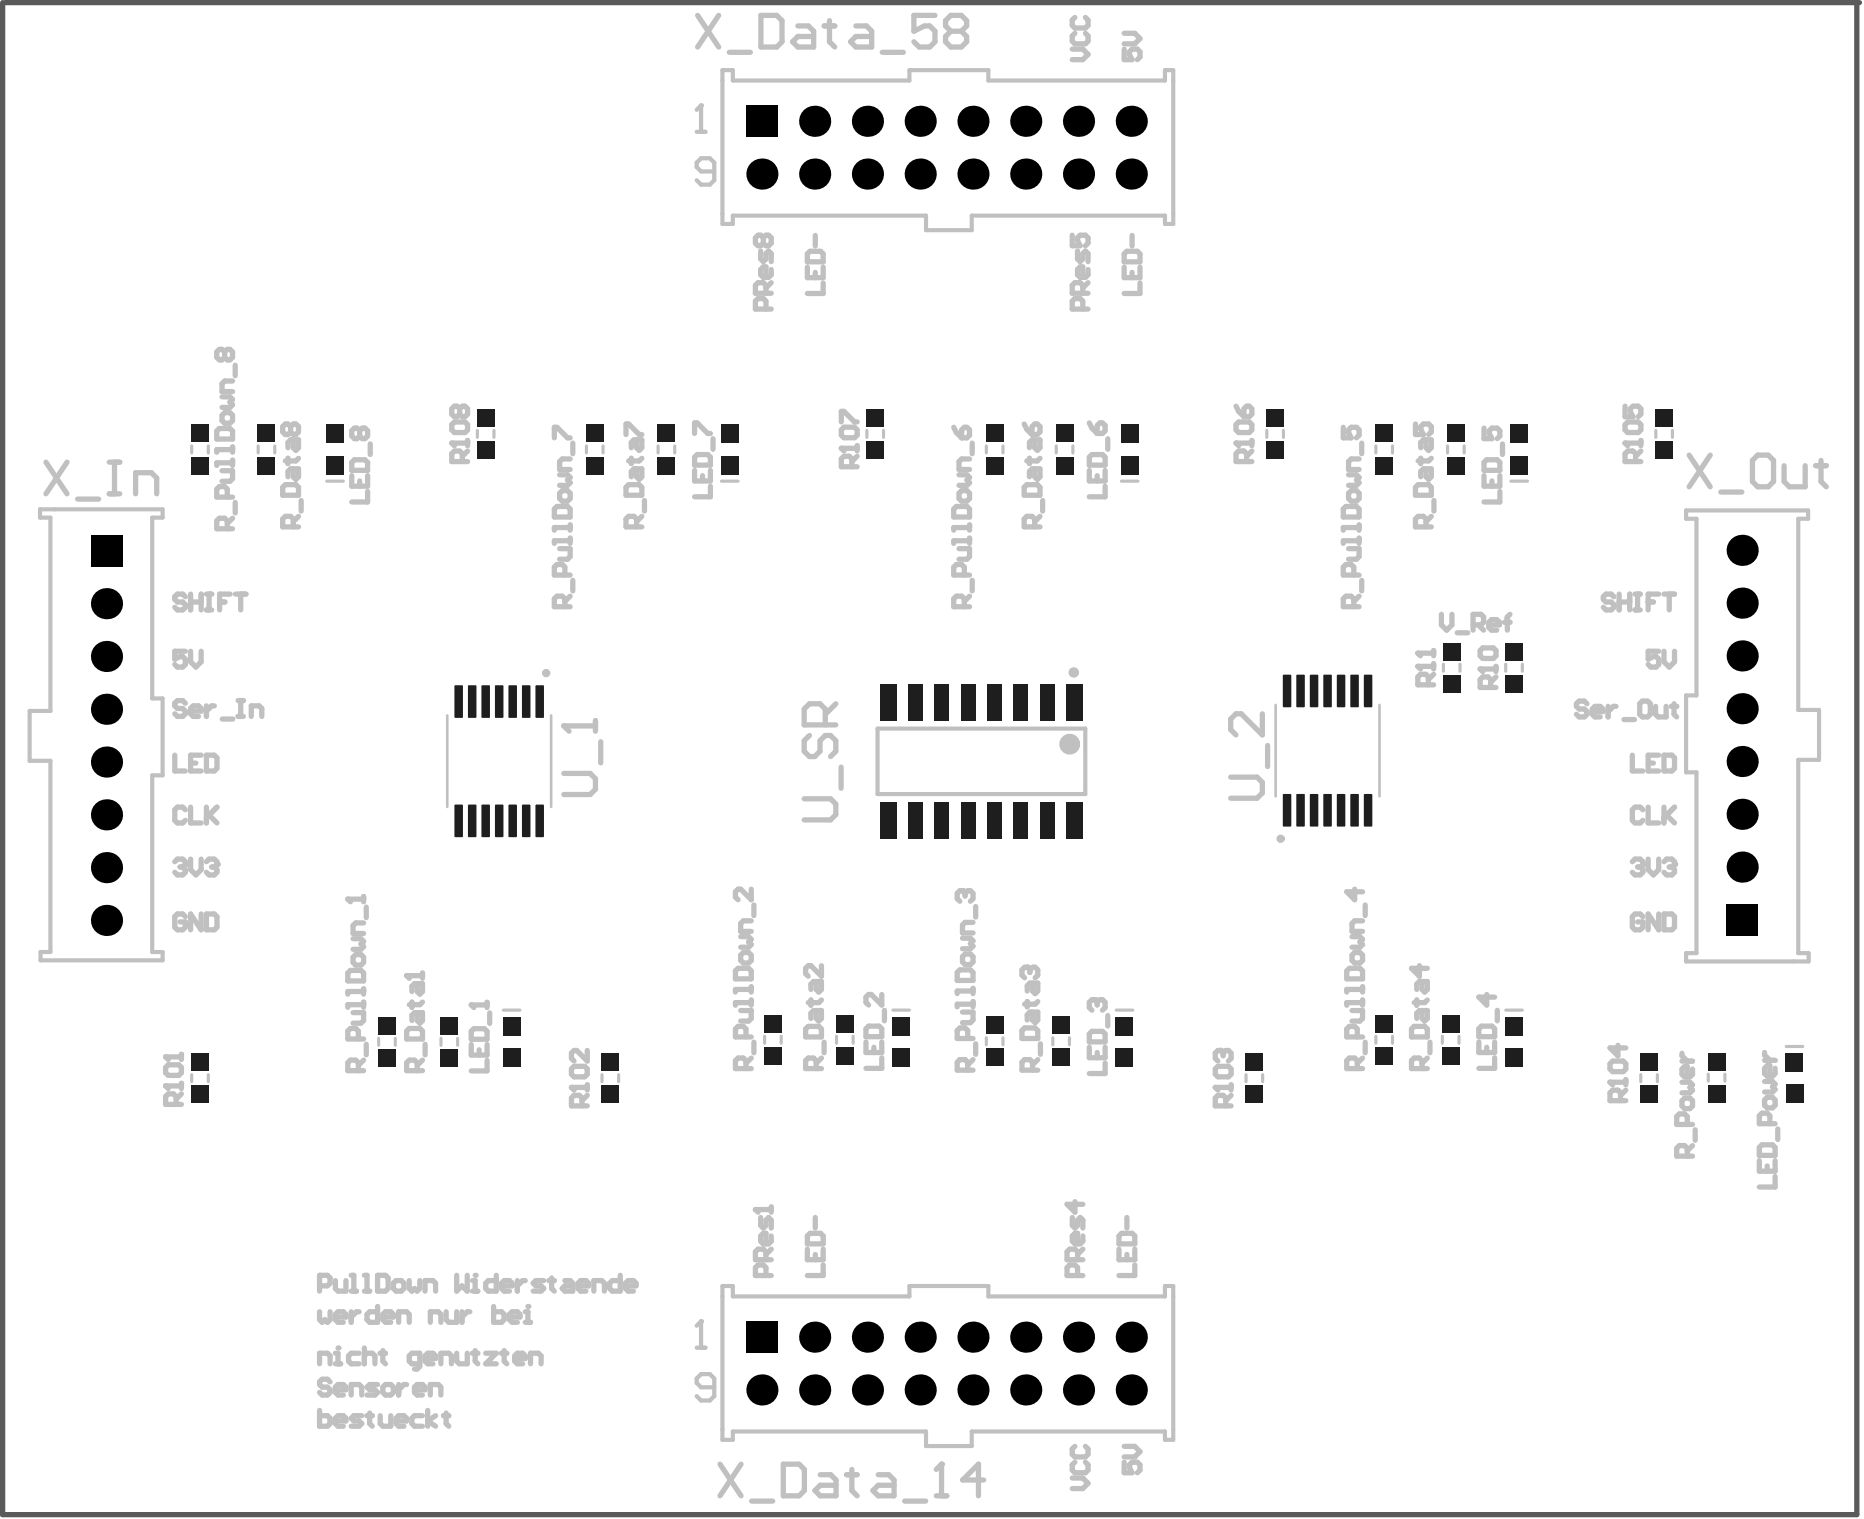
[picture p45: page 1]

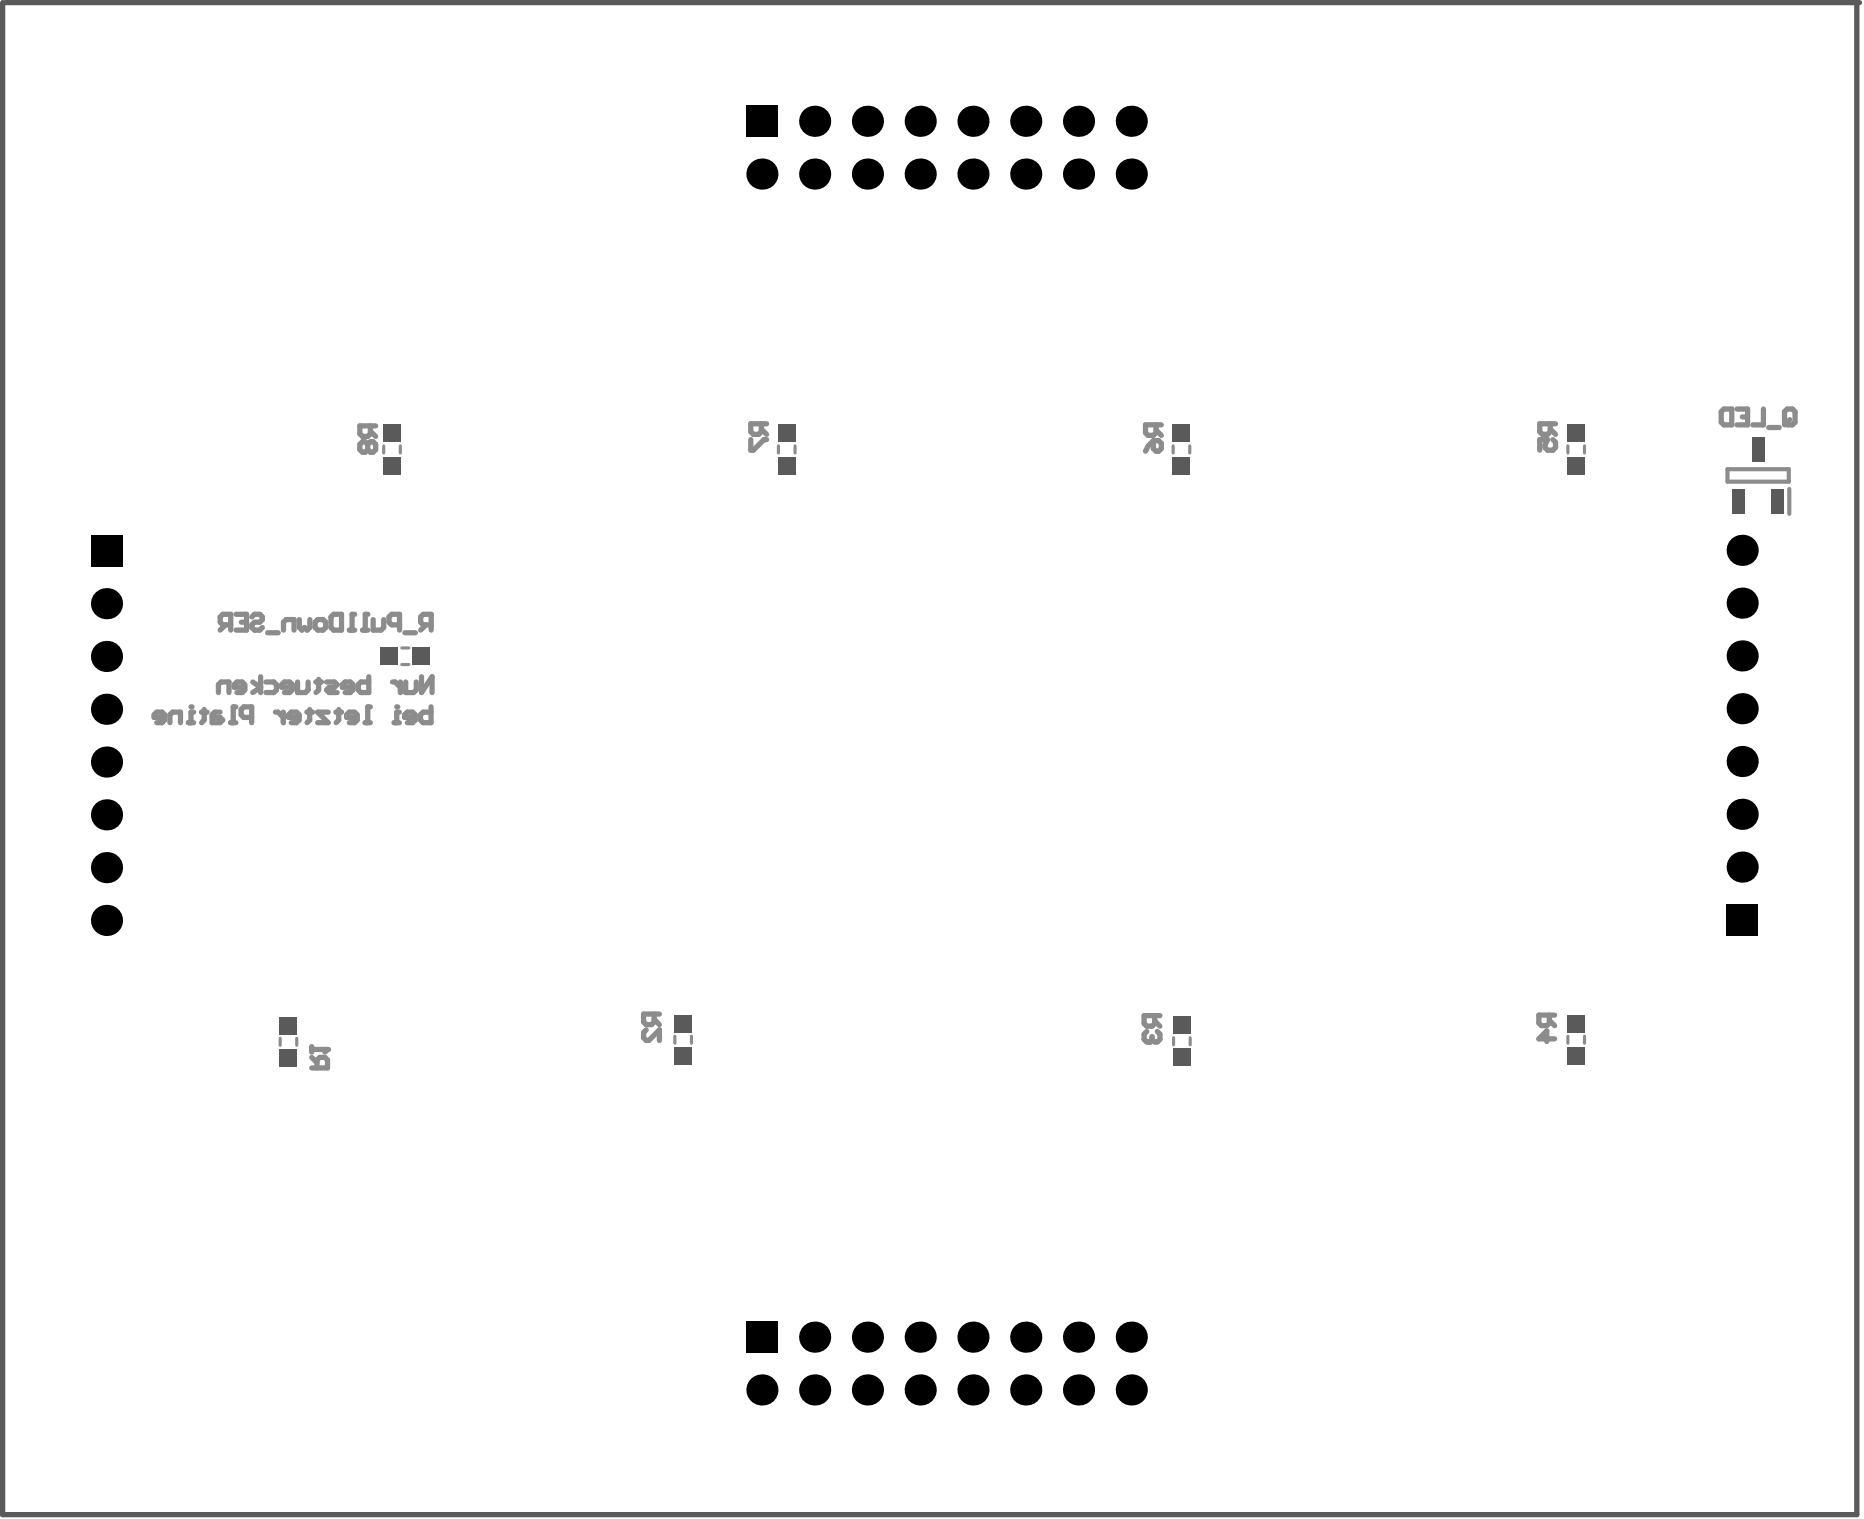
[picture p46: page 2]
