SebastianHampl18/Projektarbeit-Bierautomat/(list of files, drawings)

Other design files:
Altiumprojekt/Bierautomat.PrjPcb
Altiumprojekt/ESP_32.SchDoc
Altiumprojekt/ESP_Träger.PcbDoc
Altiumprojekt/ESP_Trägerplatine.SchDoc
Altiumprojekt/Schieberegister_Trägerplatine.SchDoc
Altiumprojekt/SR_Träger.PcbDoc
