SebastianHampl18/Projektarbeit-Bierautomat/(commit log)

2025-01-19 Das altium Projekt mit allen dazugehörigen Schaltplan und Platinen dokumenten, sowie den Outputfiles wie Gerber und Stepdateien
    [BOM_ESP_Träger.xlsx, BOM_SR_Platine.xlsx, Bierautomat.PrjPcb, ESP_32.SchDoc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]
2025-03-06 Hardwaredokumentation hinzugefügt; Datenblätter für Komparator und Schieberegister
2025-03-26 PCB 3D Prints erzeugt
    [SR_Träger.PcbDoc]
2025-03-30 CAD Ordner
    [SR_Träger.PcbDoc]
